HaHaSDP-UCSC/hahardware/specs/patch_antenna-calculations.xlsx

Manufacturer | Bay Area Circuits
Dielectric Material | FR-4
Dielectric Constant | 4.58 | +/-0.02
Dielectric Constant (Effective) | 4.272837247
Trace Height (mils) | 1.9 | +/-0.2
Dielectric Height (mils) | 57
Frequency (GHz) | 2.45
Effective Wavelength (mm) | 59.23753727
Effective Wavelength (mils) | 2332.187766 | 1166.093883 | 583.0469415
Reference | Micro_strip_Patch_Antenna for_2.4_GHZ_Wireless_Applications.pdf |  |  |  |  |  |  |  |  | Note: Width and length are swapped from reference paper.
 | Ground (mm) | Ground (mils) | Substrate (mm) | Substrate (mils) | Patch (mm) | Patch (mils) | Feed (mm) | Feed (mils)
Width | 42 | 1653.5442 | 42 | 1653.5442 | 33 | 1299.2133 | 13 | 511.8113 | 0.5570792022 | of effective wavelength
Length | 47 | 1850.3947 | 47 | 1850.3947 | 38 | 1496.0638 | 3 | 118.1103 | 0.6414851419 | of effective wavelength
Height | 0.2 | 7.87402 | 1.5 | 59.05515 | 0.02 | 0.787402 | 0.02 | 0.787402
 | Notes: | Effecitve dielectric constant of reference design is 3.86.
Actual Design r0.1
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
