HaHaSDP-UCSC/hahardware/specs/base-power_budget.xlsx

Sheet: Kinetis-AT86RF (Inactive)
Typical Power
 |  | V_CC (V) | I_CC (mA) | Power (mW) | %_On | Energy (mWh) | Notes
Kinetis MKW31Z uC |  | 3.3 | 7.2 | 23.76 | 1 | 23.76 | Using run mode current, all clocks enabled.
Kinetis MKW31Z 2.4GHz Antenna RX |  | 3.3 | 6.76 | 22.308 | 0.2 | 4.4616 | Follows "keep-alive" signal.
Kinetis MKW31Z 2.4GHz Antenna TX |  | 3.3 | 6.08 | 20.064 | 0.2 | 4.0128 | Using +0dBm. Send 2 second "keep-alive" signal every 10 seconds.
Kinetis MKW31Z 2.4GHz Antenna Standby |  | 3.3 | 0.2 | 0.66 | 0.6 | 0.396
Atmel AT86RF212B 900MHz Antenna RX |  | 3 | 9.2 | 27.6 | 0.9 | 24.84 | RX if not TX to keep mesh network alive.
Atmel AT86RF212B 900MHz Antenna TX |  | 3 | 23 | 69 | 0.1 | 6.9 | Using +5dBm normal mode. 1 second transmit every 10 seconds.
Atmel AT86RF212B 900MHz Antenna Standby |  | 3 | 0.45 | 1.35 | 0 | 0
TI LM8330 Keypad |  | 1.8 | 0.03 | 0.054 | 0.05 | 0.0027
Crystalfontz CFAH1604A-YYH-JT LCD Controller |  | 3.3 | 1.2 | 3.96 | 0.05 | 0.198
Crystalfontz CFAH1604A-YYH-JT LCD Backlight |  | 4.2 | 220 | 924 | 0.05 | 46.2
LED Lights |  | 12 | 160 | 1920 | 0.01 | 19.2
Audio Speaker |  |  | 125 | 700 | 0.01 | 7
 | Max |  | 559.12
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
