HaHaSDP-UCSC/hahardware/specs/ifa-calculations.xlsx

Manufacturer | Bay Area Circuits
Dielectric Material | FR-4
Dielectric Constant | 4.58 | +/-0.02
Dielectric Constant (Effective) | 4.171349466
Trace Height (mils) | 1.9 | +/-0.2
Dielectric Height (mils) | 57
Frequency (GHz) | 2.45
Effective Wavelength (mm) | 59.95382316
Effective Wavelength (mils) | 2360.388013 | 1180.194007 | 590.0970033
Reference | TI-swru120b.pdf (DN007) |  |  |  |  |  |  | Note: Dielectric information and ground/sides dimensions not given.
 |  | (mm) | (mils) |  | (mm) | (mils)
 | H1 | 5.7 | 224.40957 | W2 | 0.46 | 18.110246
 | H2 | 0.74 | 29.133874 | L1 | 25.58 | 1007.087158 | 0.4266616982 | of effective wavelength
 | H3 | 1.29 | 50.787429 | L2 | 16.4 | 645.66964
 | H4 | 2.21 | 87.007921 | L3 | 2.18 | 85.826818
 | H5 | 0.66 | 25.984266 | L4 | 4.8 | 188.97648
 | H6 | 1.21 | 47.637821 | L5 | 1 | 39.3701
 | H7 | 0.8 | 31.49608 | L6 | 1 | 39.3701
 | H8 | 1.8 | 70.86618 | L7 | 3.2 | 125.98432
 | H9 | 0.61 | 24.015761 | L8 | 0.45 | 17.716545
 | W1 | 1.21 | 47.637821
Actual Design
 |  | (mm) | (mils) |  | (mm) | (mils)
 | H1 | 5.689596928 | 224 | W2 | 0.4571997531 | 18
 | H2 | 0.7365996022 | 29 | L1 | 25.57778619 | 1007 | 0.4266247729 | of effective wavelength
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
