HaHaSDP-UCSC/hahardware/specs/ifa_simple-calculations.xlsx

Manufacturer | Bay Area Circuits
Dielectric Material | FR-4
Dielectric Constant | 4.58 | +/-0.02
Dielectric Constant (Effective) | 4.150918565
Trace Height (mils) | 1.9 | +/-0.2
Dielectric Height (mils) | 57
Frequency (GHz) | 2.45
Effective Wavelength (mm) | 60.10118898
Effective Wavelength (mils) | 2366.18982 | 1183.09491 | 591.5474551
Reference | NXP-AN2731.pdf (9.1 - Inverted-F Antenna) |  |  |  |  | Note: Dielectric information and ground/sides dimensions not given.
 |  | (mm) | (mils)
 | H1 | 10 | 393.701
 | H2 | 7.8 | 307.08678
 | W1 | 2.5 | 98.42525
 | W2 | 0.85 | 33.464585
 | W3 | 3 | 118.1103
 | L1 | 23.8 | 937.00838 | 0.3959988214 | of effective wavelength
 | L2 | 4.05 | 159.448905
Actual Design
 |  | (mm) | (mils)
 | H1 | 10.0075946 | 394
 | H2 | 7.797795789 | 307
 | W1 | 2.489198656 | 98
 | W2 | 0.8381995474 | 33
 | W3 | 2.997198382 | 118
 | L1 | 23.79978715 | 937 | 0.3959952798 | of effective wavelength
 | L2 | 4.038597819 | 159
 | Sides | 7.619995885 | 300
 | Notes: | CPWG feedline impedance of 49.95ohm generated with 91mil trace width and 10mil ground spacing on each side.
 |  | One row of vias placed 20mils from the keepout, 118mils apart from each other, and 61mils away from the CPWG.
