HaHaSDP-UCSC/hahardware/pcb/kicad/antenna/2.4ghz/chip/Chip Antenna/Kicad lib message.PNG

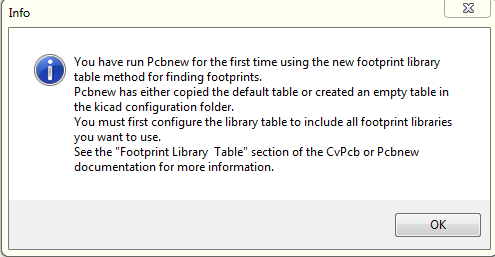
pcb/kicad/antenna/2.4ghz/chip/Chip Antenna/Kicad lib message.PNG
