HaHaSDP-UCSC/hahardware/specs/conversions.ods

L1 | 3.94 | 155.118194
L2 | 2.7 | 106.29927
L3 | 5 | 196.8505
L4 | 2.64 | 103.937064
L5 | 2 | 78.7402
L6 | 4.9 | 192.91349
W1 | 0.9 | 35.43309
W2 | 0.5 | 19.68505
D1 | 0.5 | 19.68505
D2 | 0.3 | 11.81103
D3 | 0.3 | 11.81103
D4 | 0.5 | 19.68505
D5 | 1.4 | 55.11814
D6 | 1.7 | 66.92917
WG width |  | 90.2
Gap width |  | 10
Wavelength/6 |  | 820.2083333333
Focal distance |  | 40
Via diameter |  | 12
Via drill/hole diameter |  | 10
 | 24.6 | 968.50446
 | 5.5 | 216.53555
 | 21.2 | 834.64612
 | 4 | 157.4804
