HaHaSDP-UCSC/hahardware/specs/base-bom.xlsx

Component | Part Name | Manufacturer | Package | Value | # | Supplier | Cost per 1 | Total for 1 | Cost per 50 | Total for 50 | Cost per 100 | Total for 100
B1 | KS-01Q-01 | E-Switch |  |  | 1 | Mouser | $0.52 | $0.52 | $0.45 | $22.35 | $0.43 | $43.50
B2 | KS-01Q-01 | E-Switch |  |  | 1 | Mouser | $0.52 | $0.52 | $0.45 | $22.35 | $0.43 | $43.50
B3 | KS-01Q-01 | E-Switch |  |  | 1 | Mouser | $0.52 | $0.52 | $0.45 | $22.35 | $0.43 | $43.50
B4 | KS-01Q-01 | E-Switch |  |  | 1 | Mouser | $0.52 | $0.52 | $0.45 | $22.35 | $0.43 | $43.50
B5 | KS-01Q-01 | E-Switch |  |  | 1 | Mouser | $0.52 | $0.52 | $0.45 | $22.35 | $0.43 | $43.50
C8 | GRM1555C1H100FA01D | Murata | SMT0402 | 10pF | 1 | Mouser | $0.10 | $0.10 | $0.023 | $1.15 | $0.016 | $1.60
C9 | GRM1555C1H100FA01D | Murata | SMT0403 | 10pF | 1 | Mouser | $0.10 | $0.10 | $0.023 | $1.15 | $0.016 | $1.60
C10 | GRM155R61A105KE01D | Murata | SMT0402 | 1.0uF | 1 | Mouser | $0.10 | $0.10 | $0.013 | $0.65 | $0.009 | $0.90
C11 | GRM155R61H104JE14D | Murata | SMT0402 | 0.1uF | 1 | Mouser | $0.10 | $0.10 | $0.014 | $0.70 | $0.009 | $0.90
C12 | GRM155R61H104JE14D | Murata | SMT0402 | 0.1uF | 1 | Mouser | $0.10 | $0.10 | $0.014 | $0.70 | $0.009 | $0.90
C13 | GRM155R61H104JE14D | Murata | SMT0402 | 0.1uF | 1 | Mouser | $0.10 | $0.10 | $0.014 | $0.70 | $0.009 | $0.90
C14 | 04026D475KAT2A | AVX | SMT0402 | 4.7uF | 1 | Mouser | $0.13 | $0.13 | $0.115 | $5.75 | $0.10 | $10.40
C15 | GRM155R61H104JE14D | Murata | SMT0402 | 0.1uF | 1 | Mouser | $0.10 | $0.10 | $0.014 | $0.70 | $0.0090 | $0.90
C16 | GRM155R61A225KE95D | Murata | SMT0402 | 2.2uF | 1 | Mouser | $0.10 | $0.10 | $0.060 | $3.00 | $0.027 | $2.70
C17 | GRM155R71H103JA88D | Murata | SMT0402 | 0.01uF | 1 | Mouser | $0.10 | $0.10 | $0.009 | $0.45 | $0.006 | $0.60
C18 | GRM155R61A105KE01D | Murata | SMT0402 | 1.0uF | 1 | Mouser | $0.10 | $0.10 | $0.013 | $0.65 | $0.009 | $0.90
C19 | GRM155R61A105KE01D | Murata | SMT0402 | 1.0uF | 1 | Mouser | $0.10 | $0.10 | $0.013 | $0.65 | $0.009 | $0.90
C20 | GRM155R61A105KE01D | Murata | SMT0402 | 1.0uF | 1 | Mouser | $0.10 | $0.10 | $0.013 | $0.65 | $0.009 | $0.90
C21 | GRM1555C1H470FA01D | Murata | SMT0402 | 47pF | 1 | Mouser | $0.10 | $0.10 | $0.023 | $1.15 | $0.016 | $1.60
C22 | GRM155R61A105KE01D | Murata | SMT0402 | 1.0uF | 1 | Mouser | $0.10 | $0.10 | $0.013 | $0.65 | $0.009 | $0.90
C23 | GRM155C80J106ME11D | Murata | SMT0402 | 10uF | 1 | Mouser | $0.16 | $0.16 | $0.062 | $3.10 | $0.043 | $4.30
DS1-1 | CFAH1604A-TMI-JT | Crystalfontz |  | 16x4 | 1 | Crystalfontz | $9.48 | $9.48 | $7.65 | $382.50 | $7.53 | $753.00
DS1-2 | PREC016SAAN-RC | Sullins |  |  | 1 | Digikey | $0.30 | $0.30 | $0.272 | $13.60 | $0.2239 | $22.39
DS1-3 | 310-87-116-41-001101 | Preci-Dip |  |  | 1 | Digikey | $0.91 | $0.91 | $0.796 | $39.80 | $0.6866 | $68.66
FB1 | BLM18PG181SN1D | Murata | SMT0603 |  | 1 | Mouser | $0.10 | $0.10 | $0.05 | $2.50 | $0.04 | $4.33
H1 | 302-R201 | On Shore |  |  | 1 | Digikey | $0.62 | $0.62 | $0.4632 | $23.16 | $0.4439 | $44.39
H2 | 10118194-0001LF | Amphenol |  |  | 1 | Mouser | $0.46 | $0.46 | $0.318 | $15.90 | $0.275 | $27.50
L3 | 36401E9N1ATDF | TE Connectivity | SMT0402 | 9.1nH | 1 | Mouser | $0.10 | $0.10 | $0.071 | $3.55 | $0.061 | $6.10
L4 | CV201210-4R7K | Bourns | SMT0805 | 4.7uH | 1 | Mouser | $0.10 | $0.10 | $0.048 | $2.40 | $0.039 | $3.90
P1 | OSTTE020104 | On Shore |  |  | 1 | Arrow | $0.3467 | $0.35 | $0.2442 | $12.21 | $0.2442 | $24.42
P2 | OSTTE020105 | On Shore |  |  | 1 | Arrow | $0.3467 | $0.35 | $0.2442 | $12.21 | $0.2442 | $24.42
P3 | OSTTE020106 | On Shore |  |  | 1 | Arrow | $0.3467 | $0.35 | $0.2442 | $12.21 | $0.2442 | $24.42
P4 | OSTTE020106 | On Shore |  |  | 1 | Arrow | $0.3467 | $0.35 | $0.2442 | $12.21 | $0.2442 | $24.42
Q1 | IRLML2502TRPBF | Infineon | SOT-23 |  | 1 | Mouser | $0.46 | $0.46 | $0.33 | $16.45 | $0.15 | $15.10
R2 | RCS04021K00FKED | Vishay | SMT0402 | 1kOhm | 1 | Mouser | $0.11 | $0.11 | $0.11 | $5.50 | $0.038 | $3.80
R3 | RCS0402100KFKED | Vishay | SMT0402 | 100kOhm | 1 | Mouser | $0.11 | $0.11 | $0.11 | $5.50 | $0.038 | $3.80
R4 | RCS0402100RFKED | Vishay | SMT0402 | 100 Ohm | 1 | Mouser | $0.11 | $0.11 | $0.11 | $5.50 | $0.038 | $3.80
R5 | RCS04021K00FKED | Vishay | SMT0402 | 1kOhm | 1 | Mouser | $0.11 | $0.11 | $0.11 | $5.50 | $0.038 | $3.80
RV1 | 3319W-1-103 | Bourns |  | 10kOhm | 1 | Mouser | $0.40 | $0.40 | $0.319 | $15.95 | $0.286 | $28.60
U1 | ATSAMB11G18A-MU-T | Microchip (Atmel) | QFN48 |  | 1 | Microchip | $3.51 | $3.51 | $3.21 | $160.50 | $3.02 | $302.00
U2 | XBP9B-DMST-002 | Digi |  |  | 1 | Digikey | $39.00 | $39.00 | $39.00 | $1950.00 | $39.00 | $3900.00
Y1 | ABS07AIG-32.768KHZ-6-T | Abracon | 2-SMD | 32.768kHz | 1 | Digikey | $0.71 | $0.71 | $3.21 | $160.50 | $0.52 | $51.62
Y2 | CX3225SB26000D0FFFCC | Kyocera (AVX) | 4-SMD | 26MHz | 1 | Mouser | $0.76 | $0.76 | $0.66 | $33.15 | $0.56 | $56.00
AE2-1 | ANT-916-PML | Linx |  | 916MHz | 1 | Digikey | $8.12 | $8.12 | $7.50 | $375.00 | $6.90 | $690.00
AE2-2 | 132193 | Amphenol |  |  | 1 | Newark | $6.12 | $6.12 | $5.10 | $255.00 | $4.85 | $485.00
 |  |  |  |  |  | Total |  | $77.27 |  | $3654.35 |  | $6819.87
 |  |  |  |  |  | Total per unit |  | $77.27 |  | $73.09 |  | $68.20
