HaHaSDP-UCSC/hahardware/pcb/kicad/antenna/2.4ghz/mifa_TI/SampDesign/IFA_USB.dxf

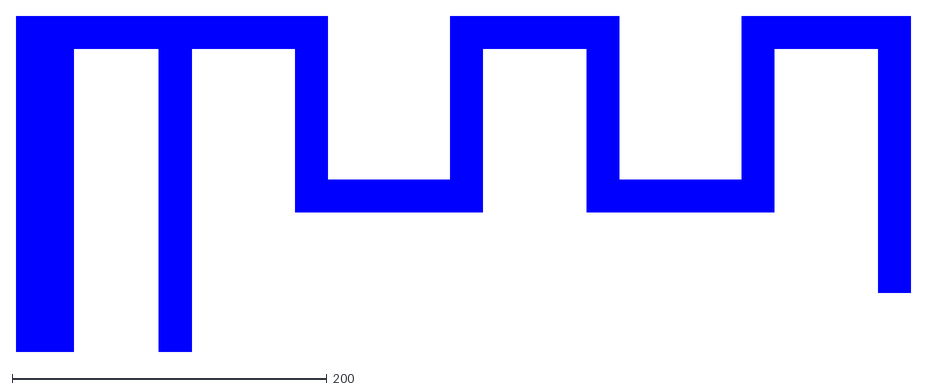
[picture p2: CAD file, 2017-06-19]
pcb/kicad/antenna/2.4ghz/mifa_TI/SampDesign/IFA_USB.dxf
567.9 x 213.2
