HaHaSDP-UCSC/hahardware/pcb/kicad/button/button_mkii/mifasketches/mifa_05-B.Cu.dxf

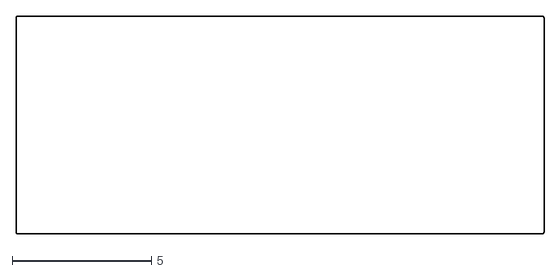
[picture p3: CAD file, 2017-06-19]
pcb/kicad/button/button_mkii/mifasketches/mifa_05-B.Cu.dxf
19.0 x 7.82
