HaHaSDP-UCSC/hahardware/pcb/kicad/button/button_mkii/mifasketches/mifa_05-F.Cu.dxf

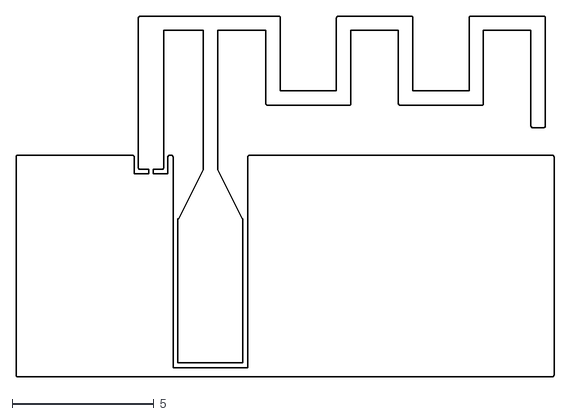
[picture p4: CAD file, 2017-06-19]
pcb/kicad/button/button_mkii/mifasketches/mifa_05-F.Cu.dxf
19.0 x 12.7
