HaHaSDP-UCSC/hahardware/(list of files, cad)

Other CAD files:
pcb/kicad/button/button_mkii/mifasketches/mifa_05-B.Adhes.dxf
pcb/kicad/button/button_mkii/mifasketches/mifa_05-F.Adhes.dxf
pcb/kicad/button/button_mkii/mifasketches/mifa_05-B.Mask.dxf
pcb/kicad/button/button_mkii/mifasketches/mifa_05-B.Paste.dxf
pcb/kicad/button/button_mkii/mifasketches/mifa_05-B.SilkS.dxf
pcb/kicad/button/button_mkii/mifasketches/mifa_05-F.Mask.dxf
pcb/kicad/button/button_mkii/mifasketches/mifa_05-F.Paste.dxf
pcb/kicad/button/button_mkii/mifasketches/mifa_05-F.SilkS.dxf
