HaHaSDP-UCSC/hahardware/pcb/kicad/base/base-schematic.pdf

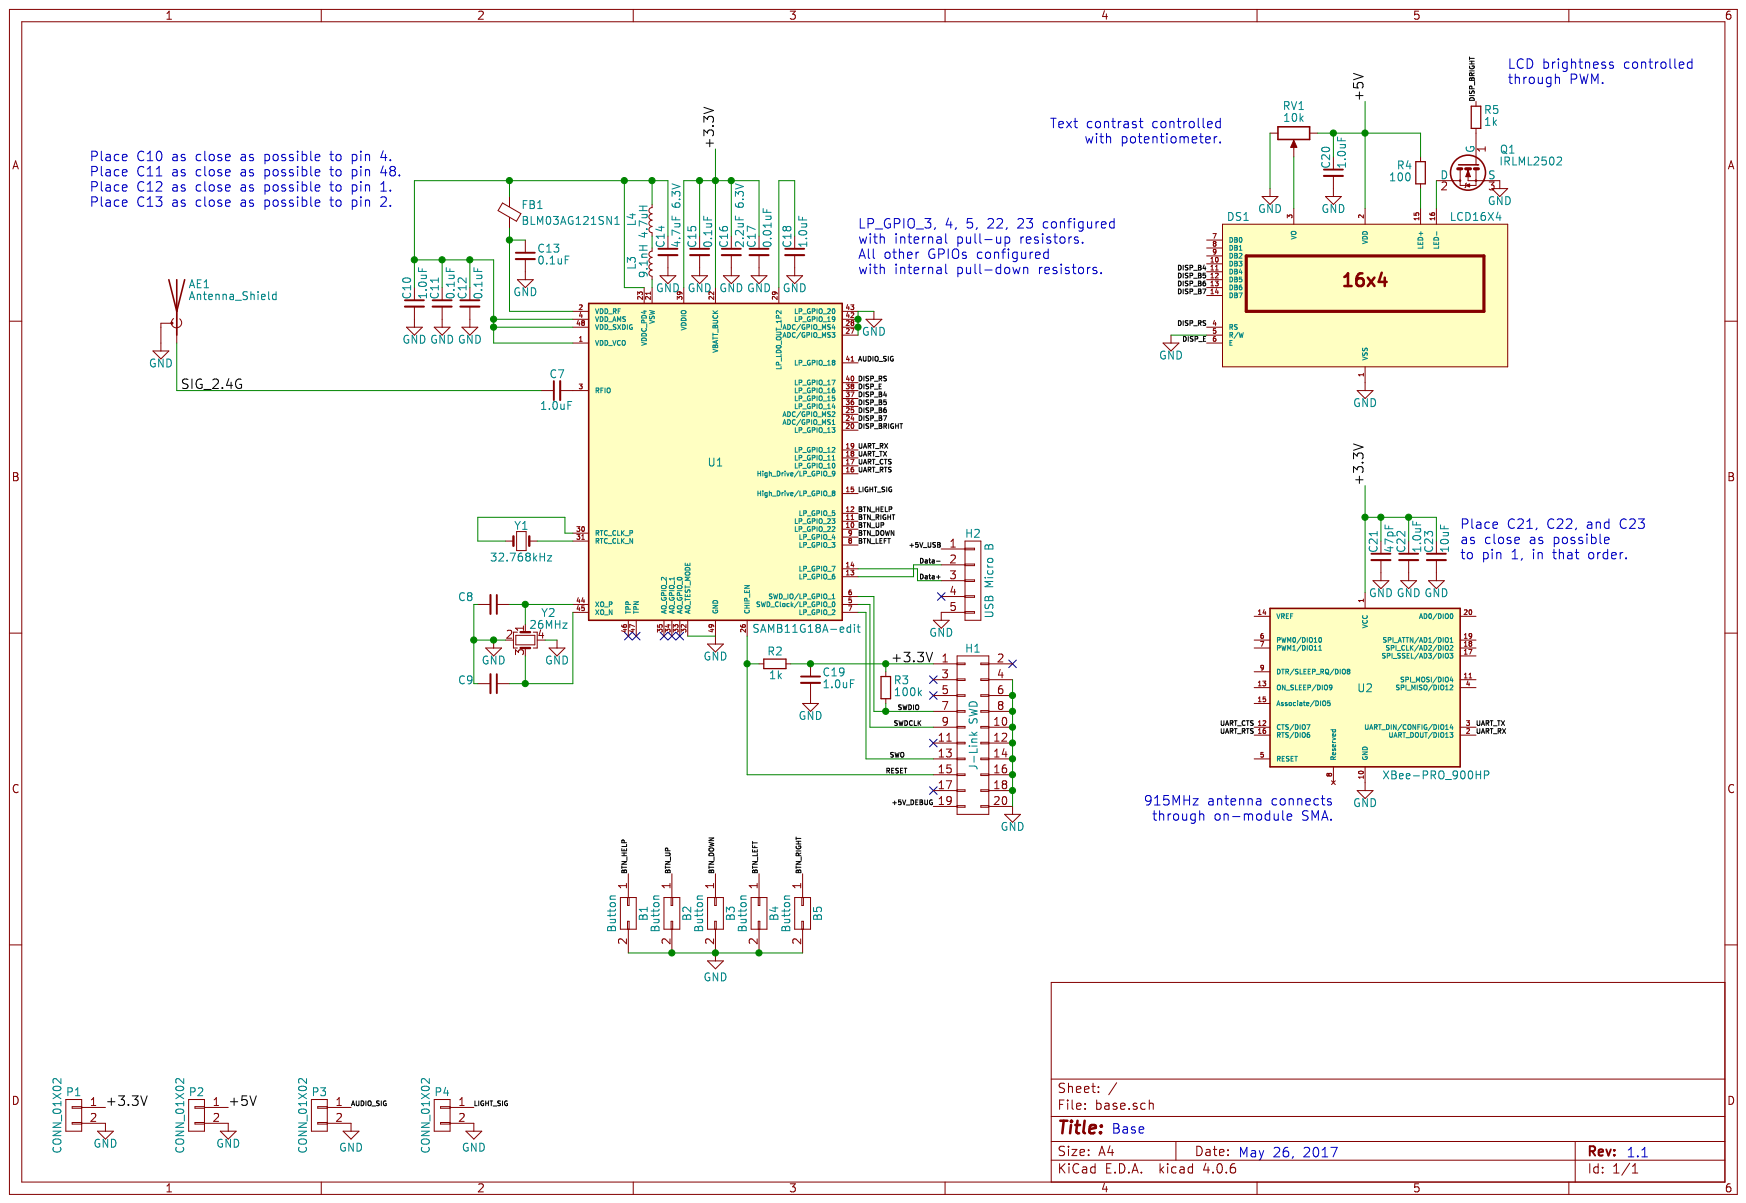
[picture p5: page 1]
