HaHaSDP-UCSC/hahardware/pcb/kicad/artwork/base-bot.pdf

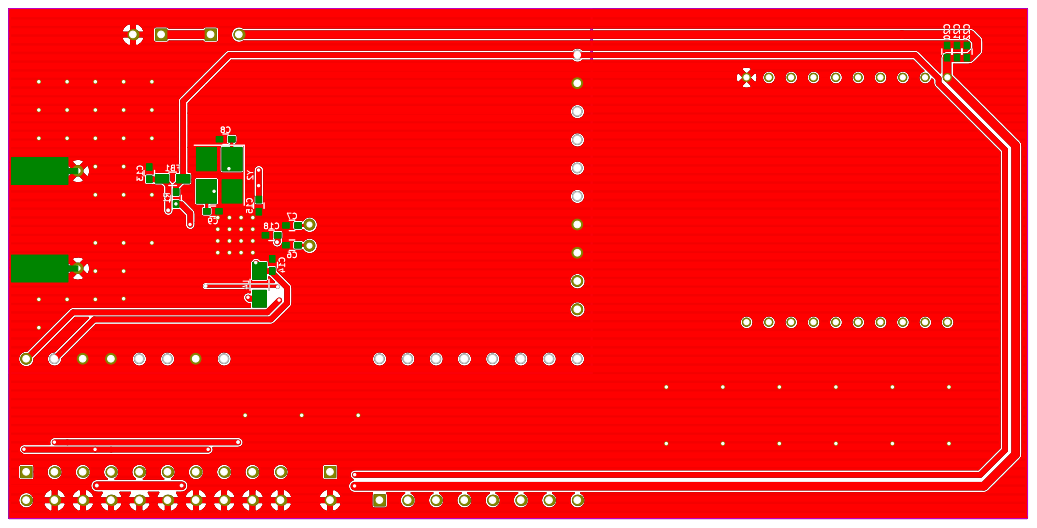
[picture p6: page 1]
