HaHaSDP-UCSC/hahardware/pcb/kicad/artwork/base-top.pdf

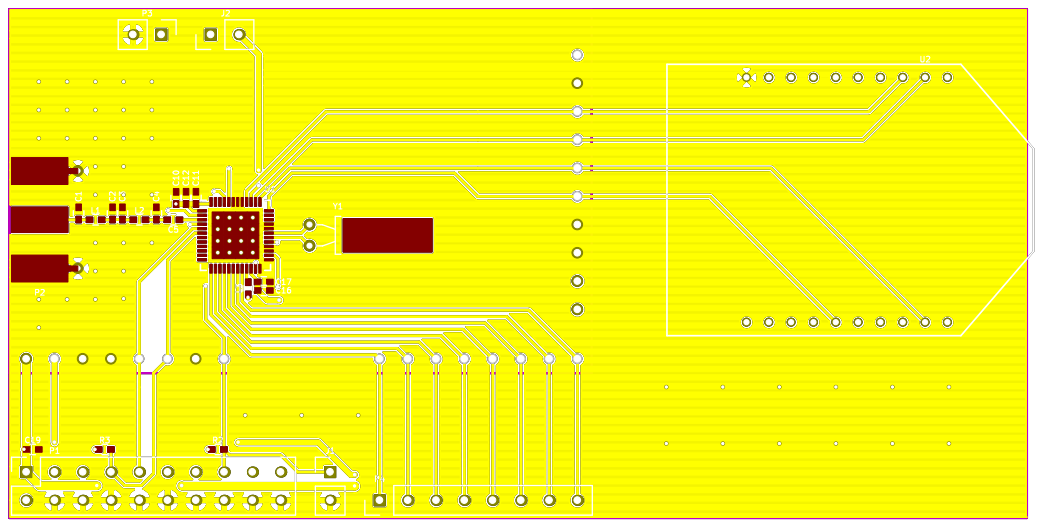
[picture p7: page 1]
