HaHaSDP-UCSC/hahardware/pcb/kicad/base/artwork/base-bot.pdf

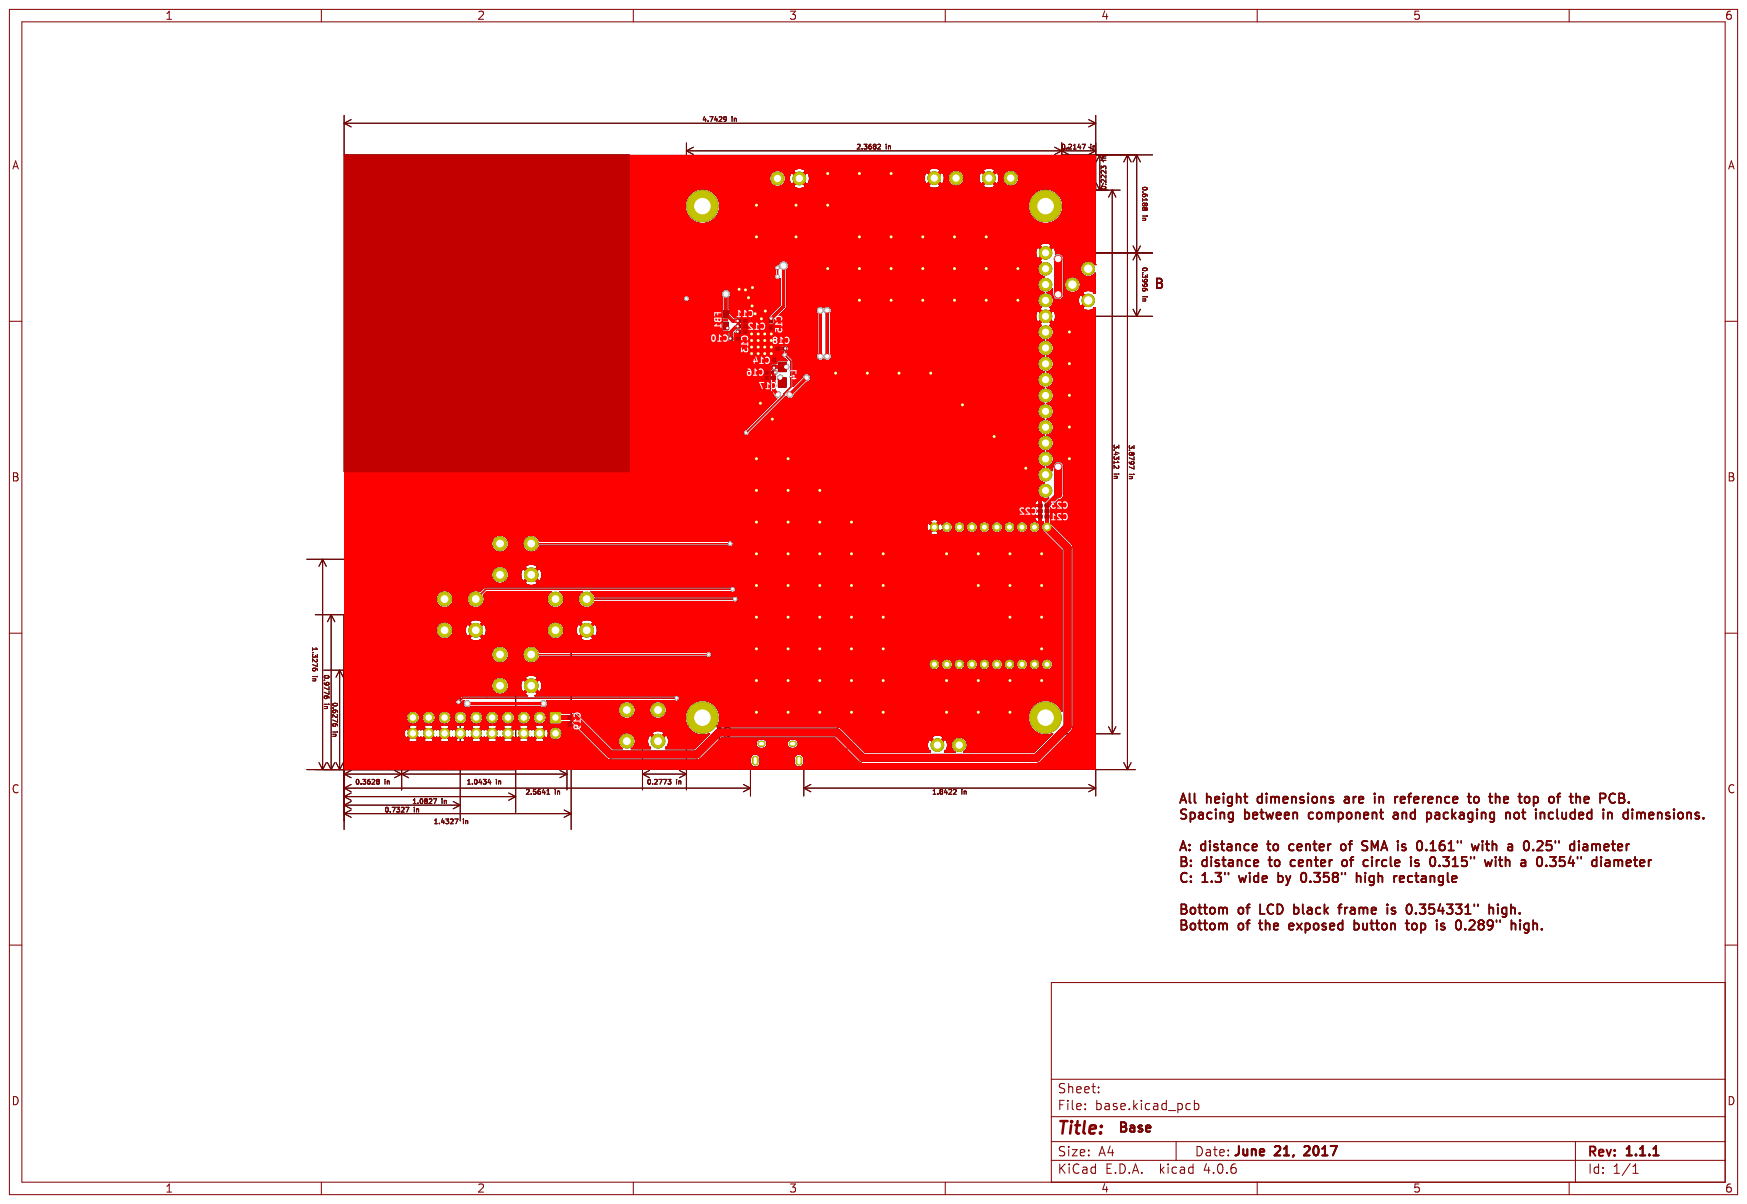
[picture p8: page 1]
