HaHaSDP-UCSC/hahardware/pcb/kicad/base/artwork/base-top.pdf

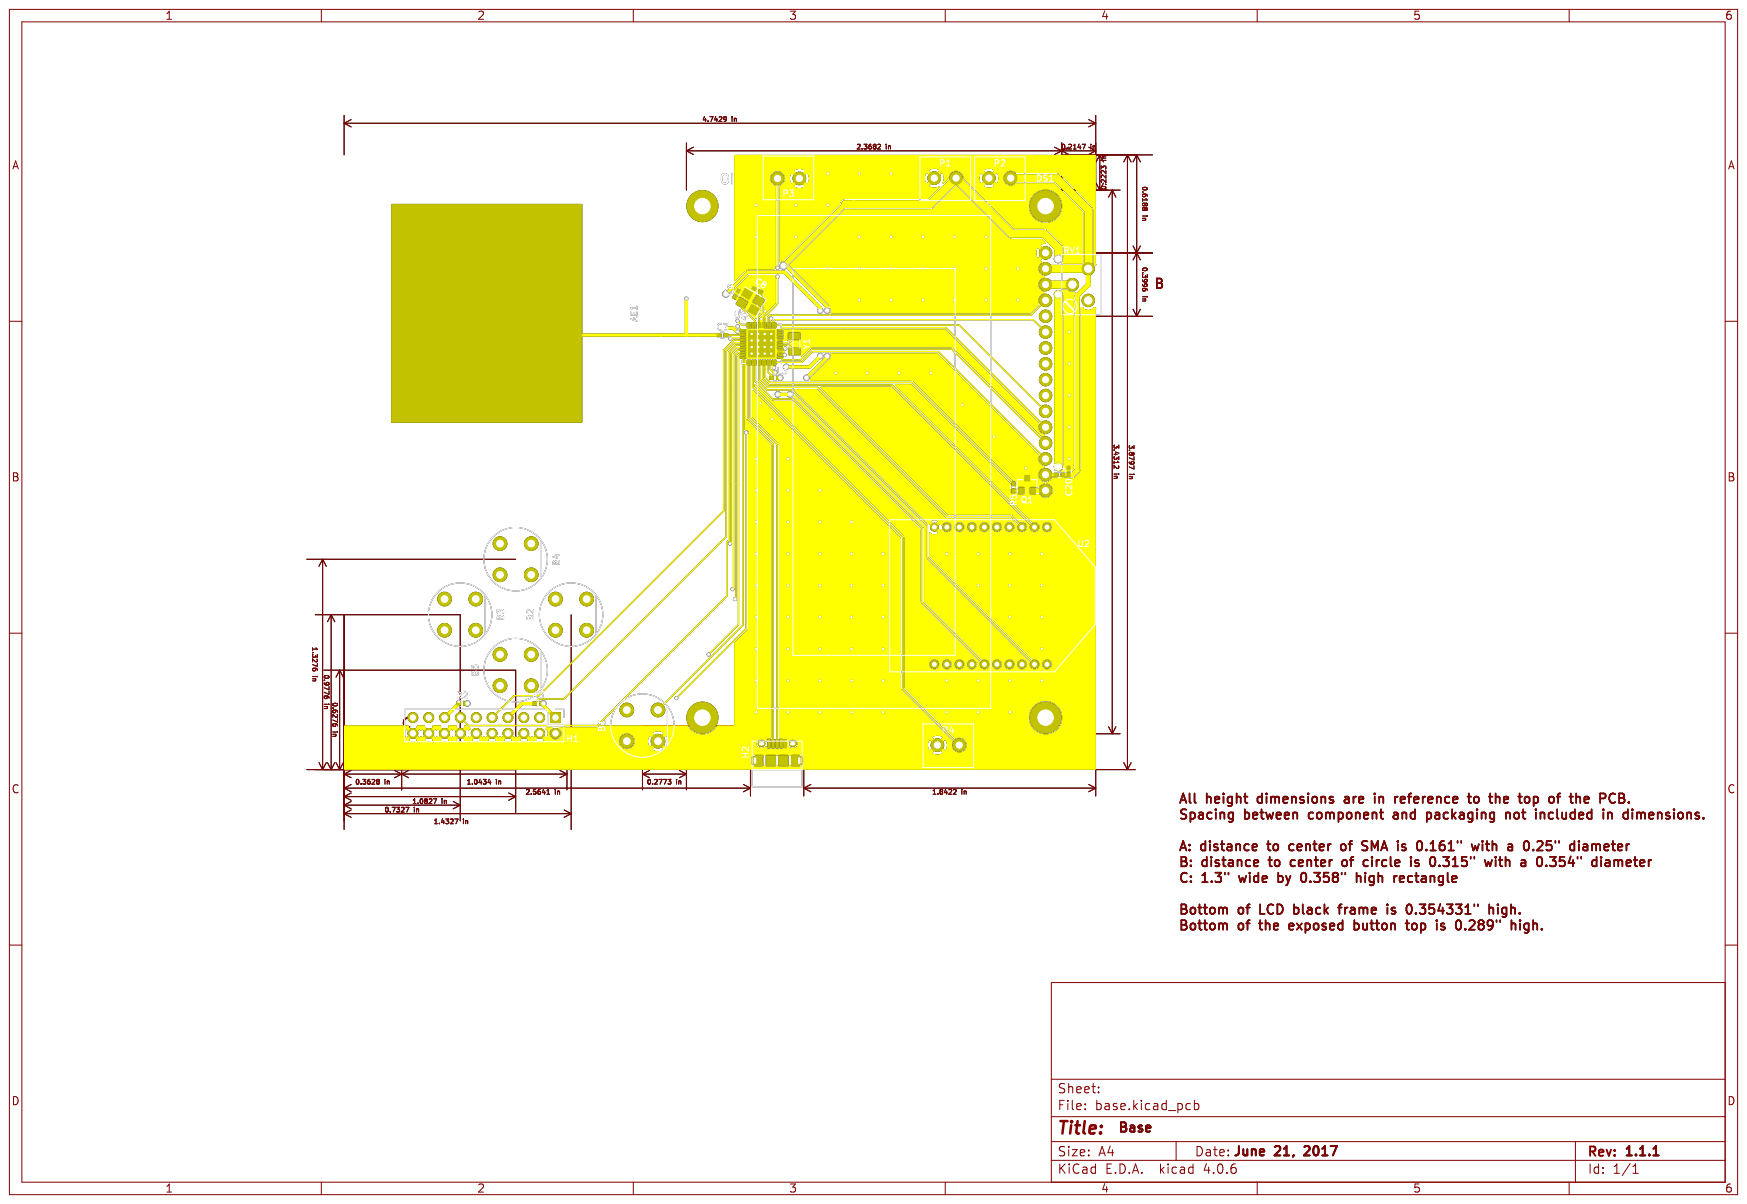
[picture p9: page 1]
