HaHaSDP-UCSC/hahardware/pcb/kicad/button/button_mki/mki.pdf

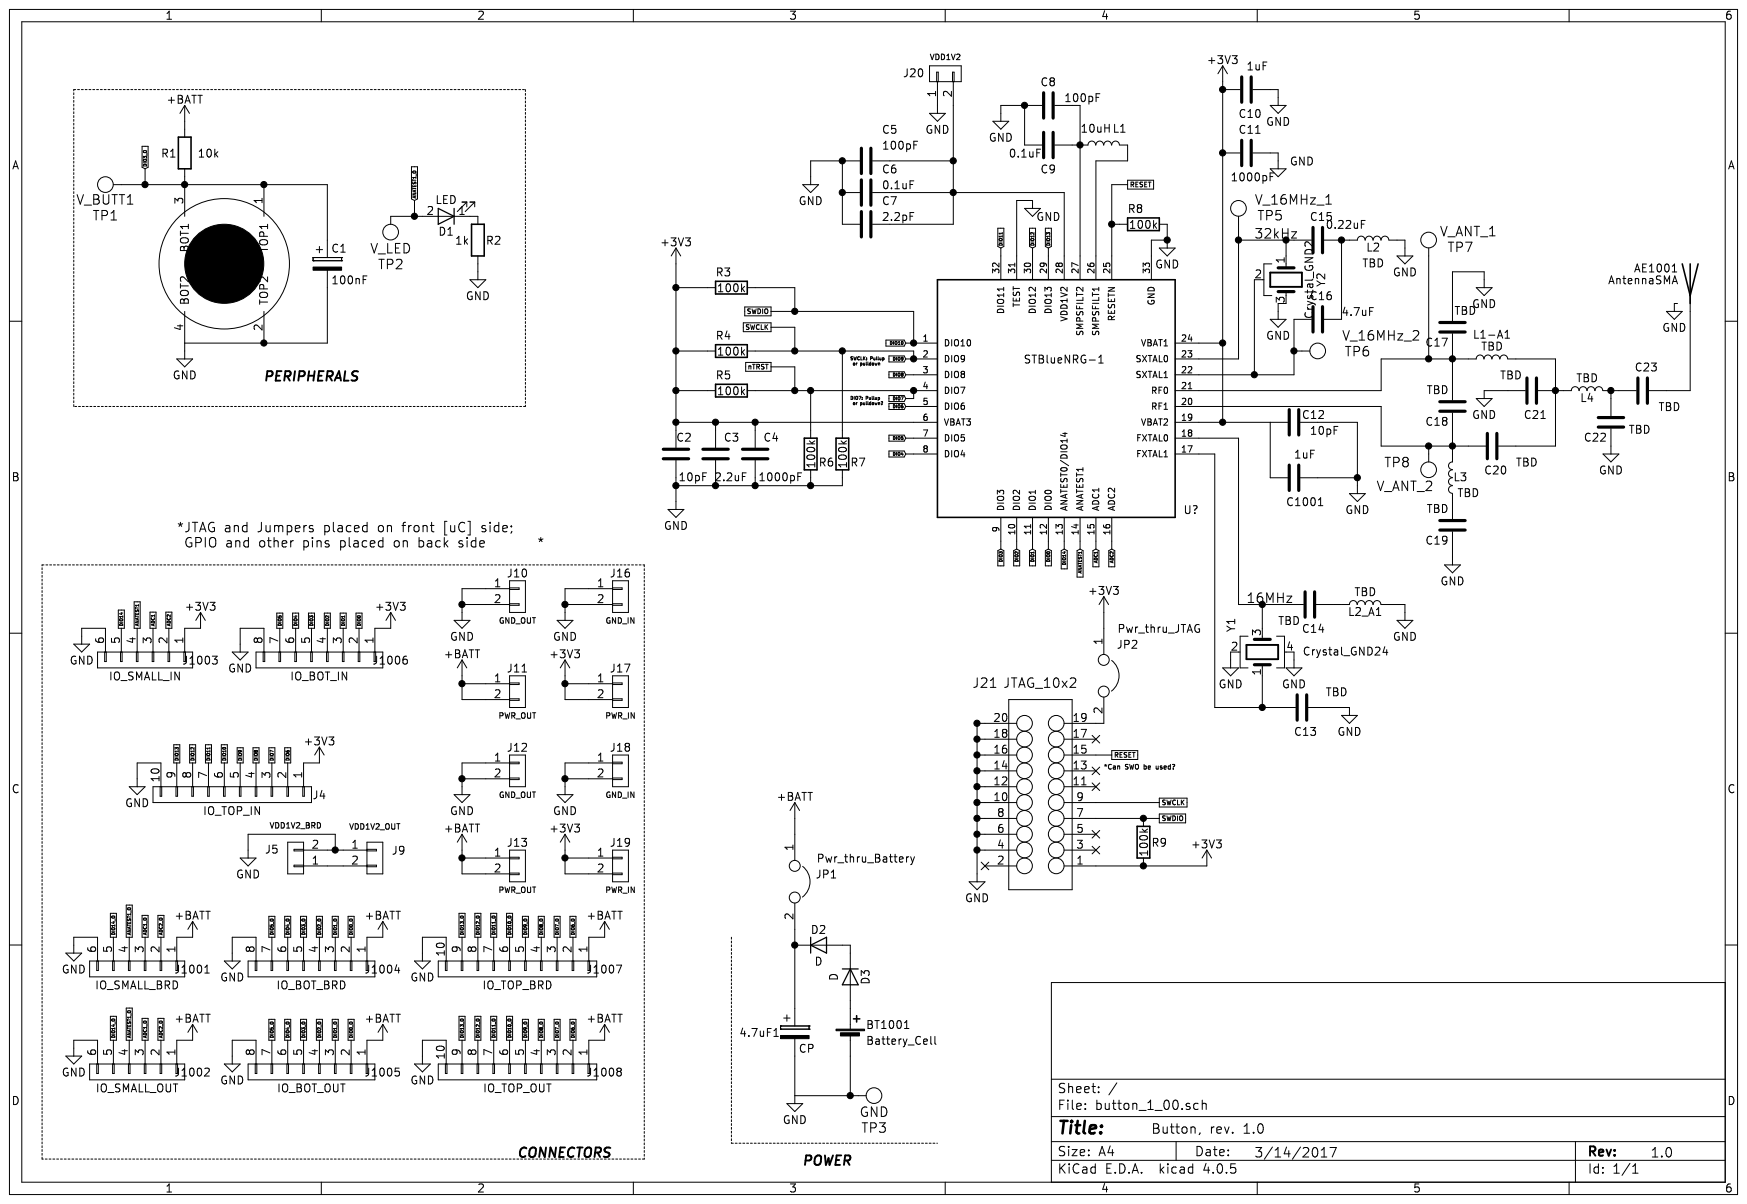
[picture p10: page 1]
