HaHaSDP-UCSC/hahardware/pcb/kicad/antenna/2.4ghz/ifa_simple/ifa_simple.pdf

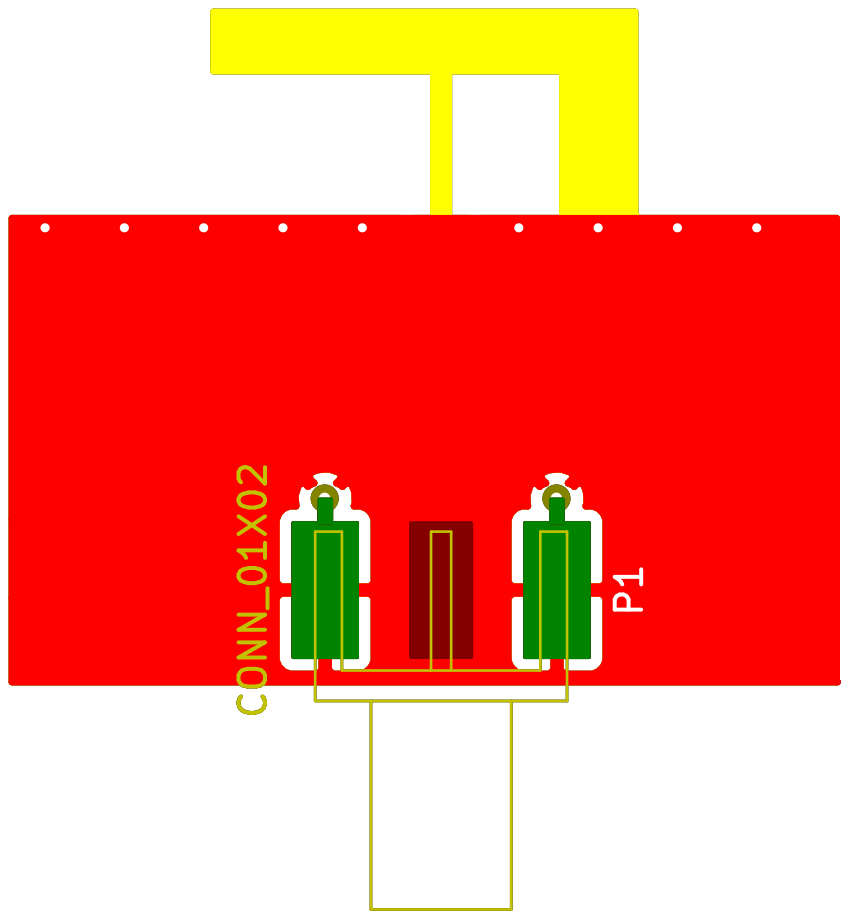
[picture p23: page 1]
