HaHaSDP-UCSC/hahardware/pcb/kicad/antenna/2.4ghz/mifa/mifa.pdf

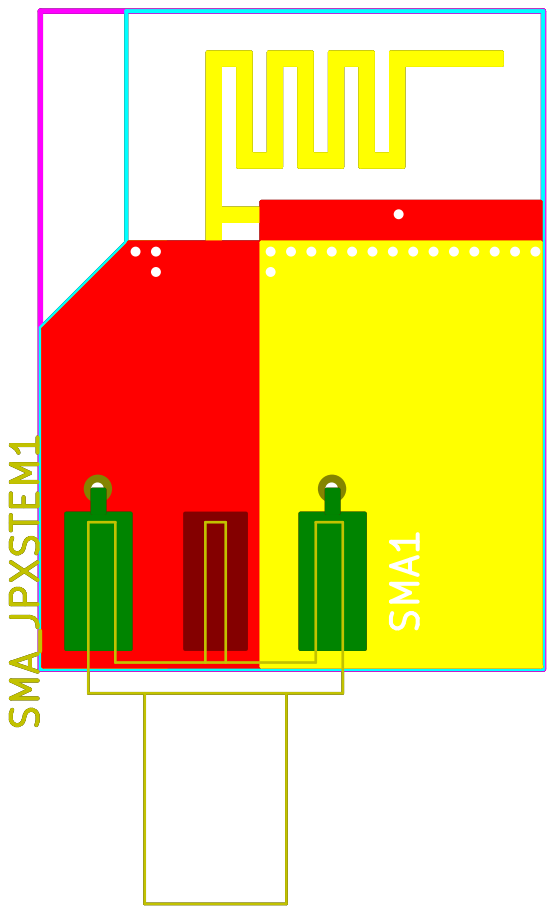
[picture p24: page 1]
