HaHaSDP-UCSC/hahardware/pcb/kicad/antenna/2.4ghz/ifa/ifa.pdf

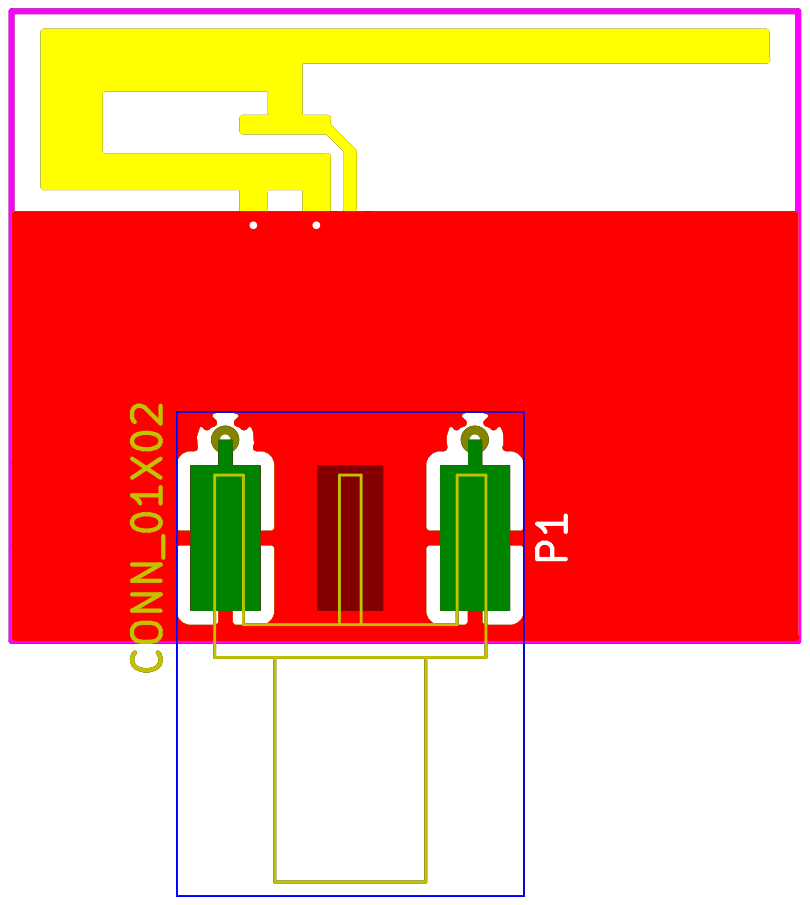
[picture p25: page 1]
