HaHaSDP-UCSC/hahardware/pcb/kicad/antenna/2.4ghz/patch_match/artwork/patch_match-bot.pdf

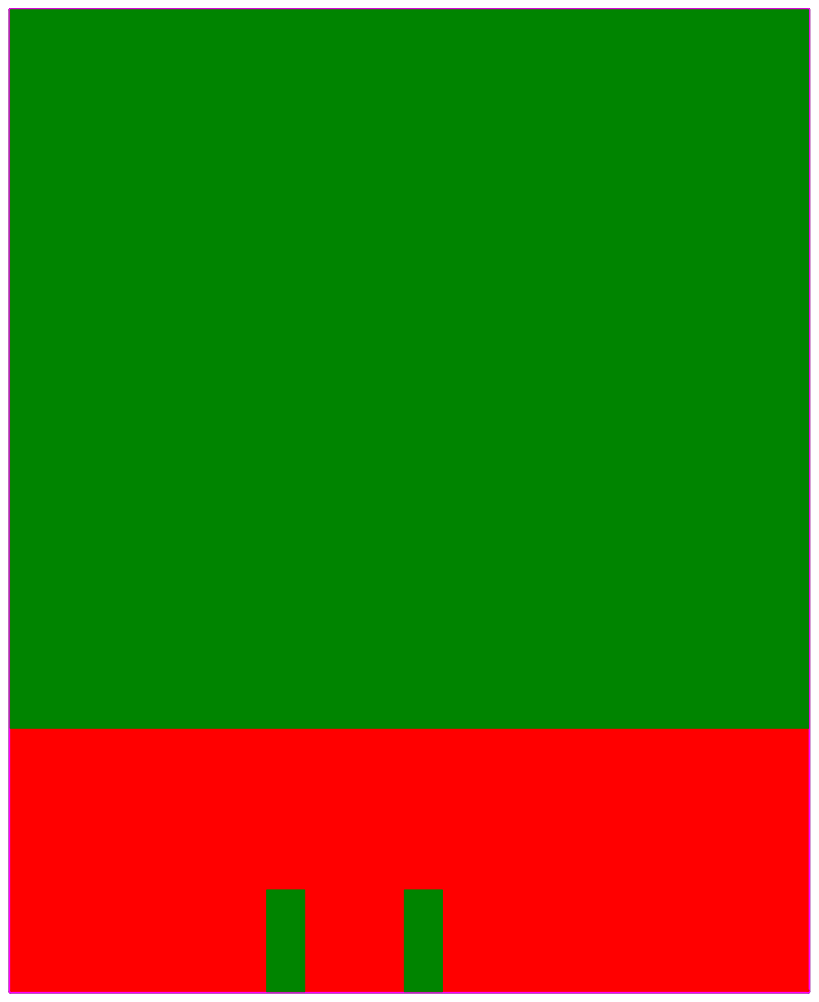
[picture p26: page 1]
