HaHaSDP-UCSC/hahardware/pcb/kicad/antenna/2.4ghz/patch_match/artwork/patch_match-top.pdf

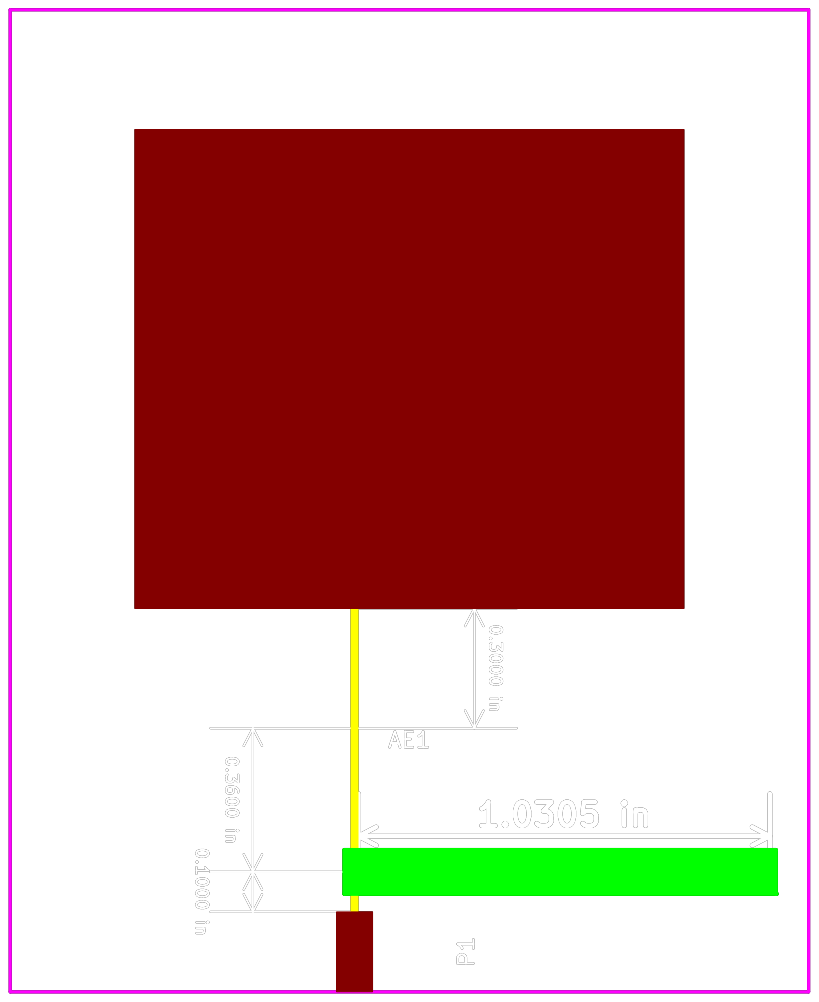
[picture p27: page 1]
