HaHaSDP-UCSC/hahardware/pcb/kicad/antenna/2.4ghz/patch/artwork/patch-bot.pdf

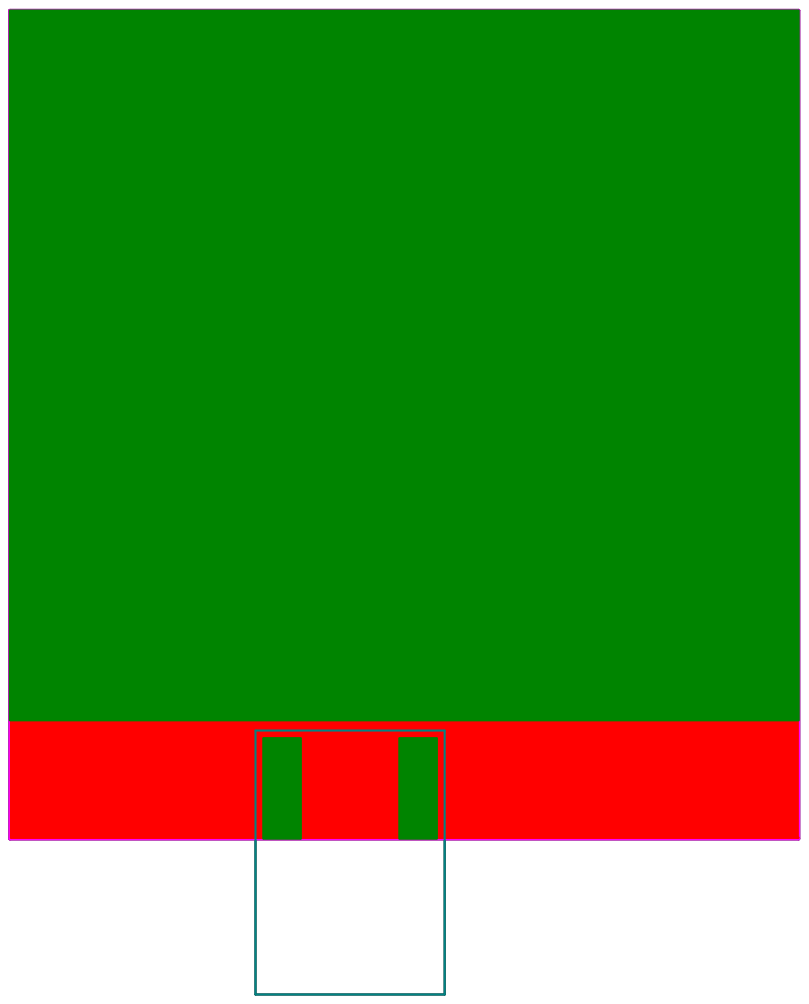
[picture p28: page 1]
