HaHaSDP-UCSC/hahardware/pcb/kicad/antenna/2.4ghz/patch/artwork/patch-top.pdf

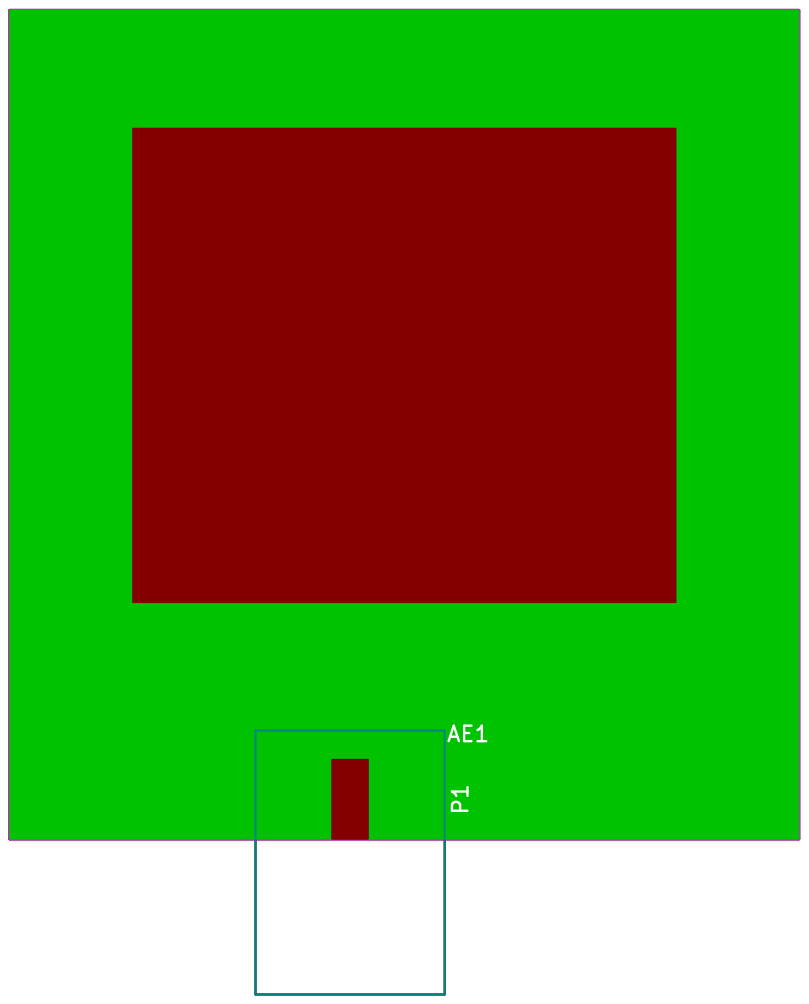
[picture p29: page 1]
