HaHaSDP-UCSC/hahardware/pcb/kicad/antenna/2.4ghz/patch_balun/artwork/patch_balun-bot.pdf

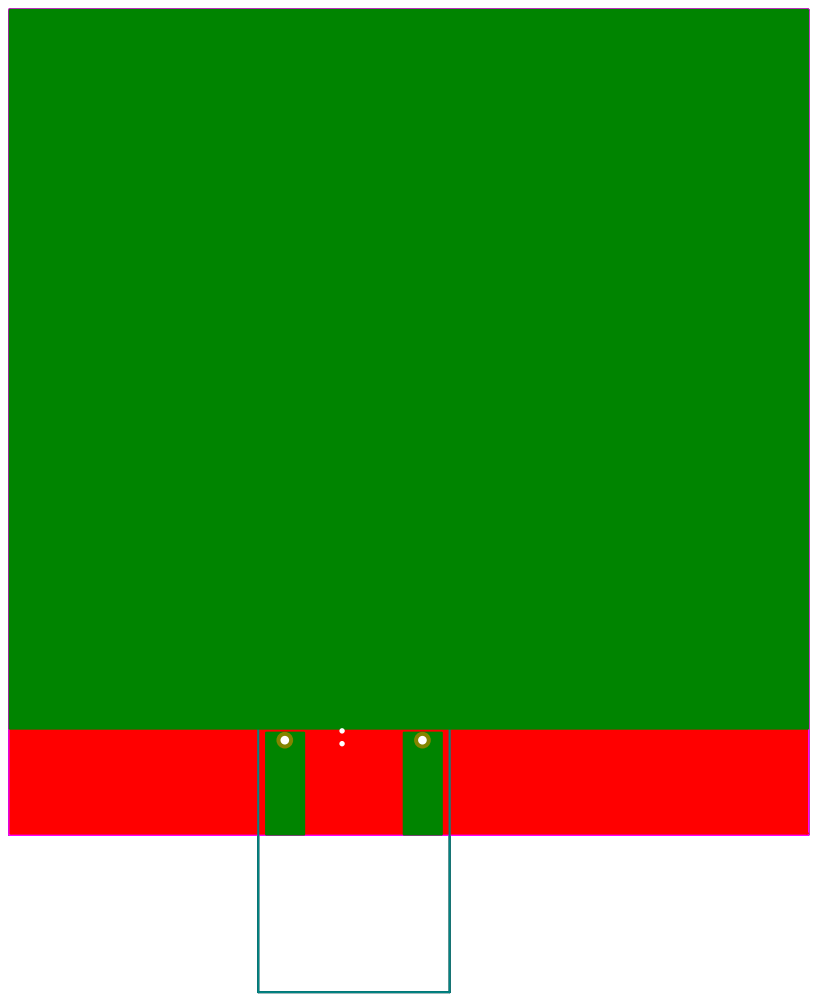
[picture p30: page 1]
