HaHaSDP-UCSC/hahardware/pcb/kicad/antenna/2.4ghz/patch_balun/artwork/patch_balun-top.pdf

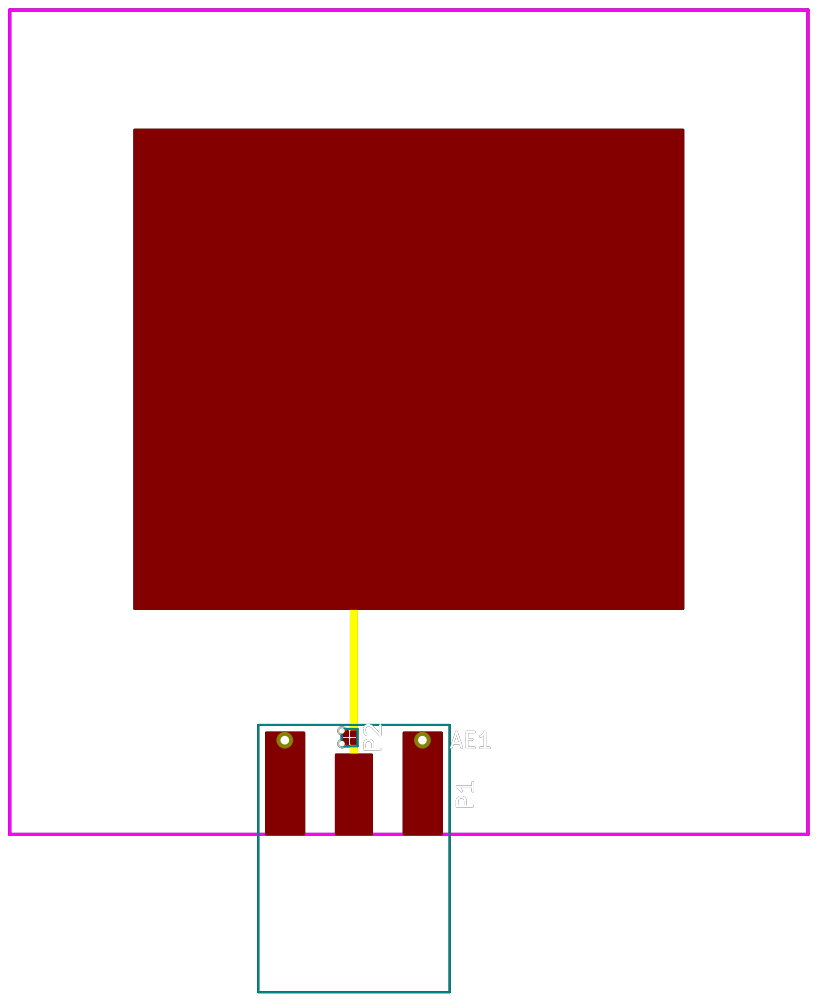
[picture p31: page 1]
