HaHaSDP-UCSC/hahardware/pcb/kicad/antenna/2.4ghz/chip/antenova/rufa.pdf

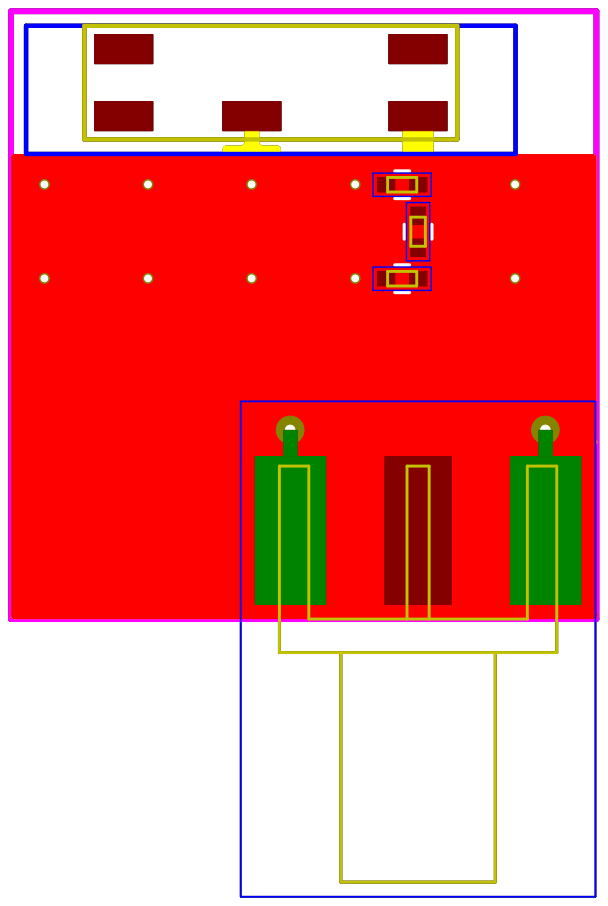
[picture p32: page 1]
