HaHaSDP-UCSC/hahardware/(list of files, drawings)

Other design files:
pcb/kicad/antenna/2.4ghz/mifa_TI/SampDesign/CC2511_USB_Dongle_1_3.pcb
pcb/kicad/button/button_mkii/mifasketches/mifa_05.dsn
