HaHaSDP-UCSC/hahardware/pcb/kicad/base/base.kicad_pcb

## KiCad design pcb/kicad/base/base.kicad_pcb (2017-06-22)

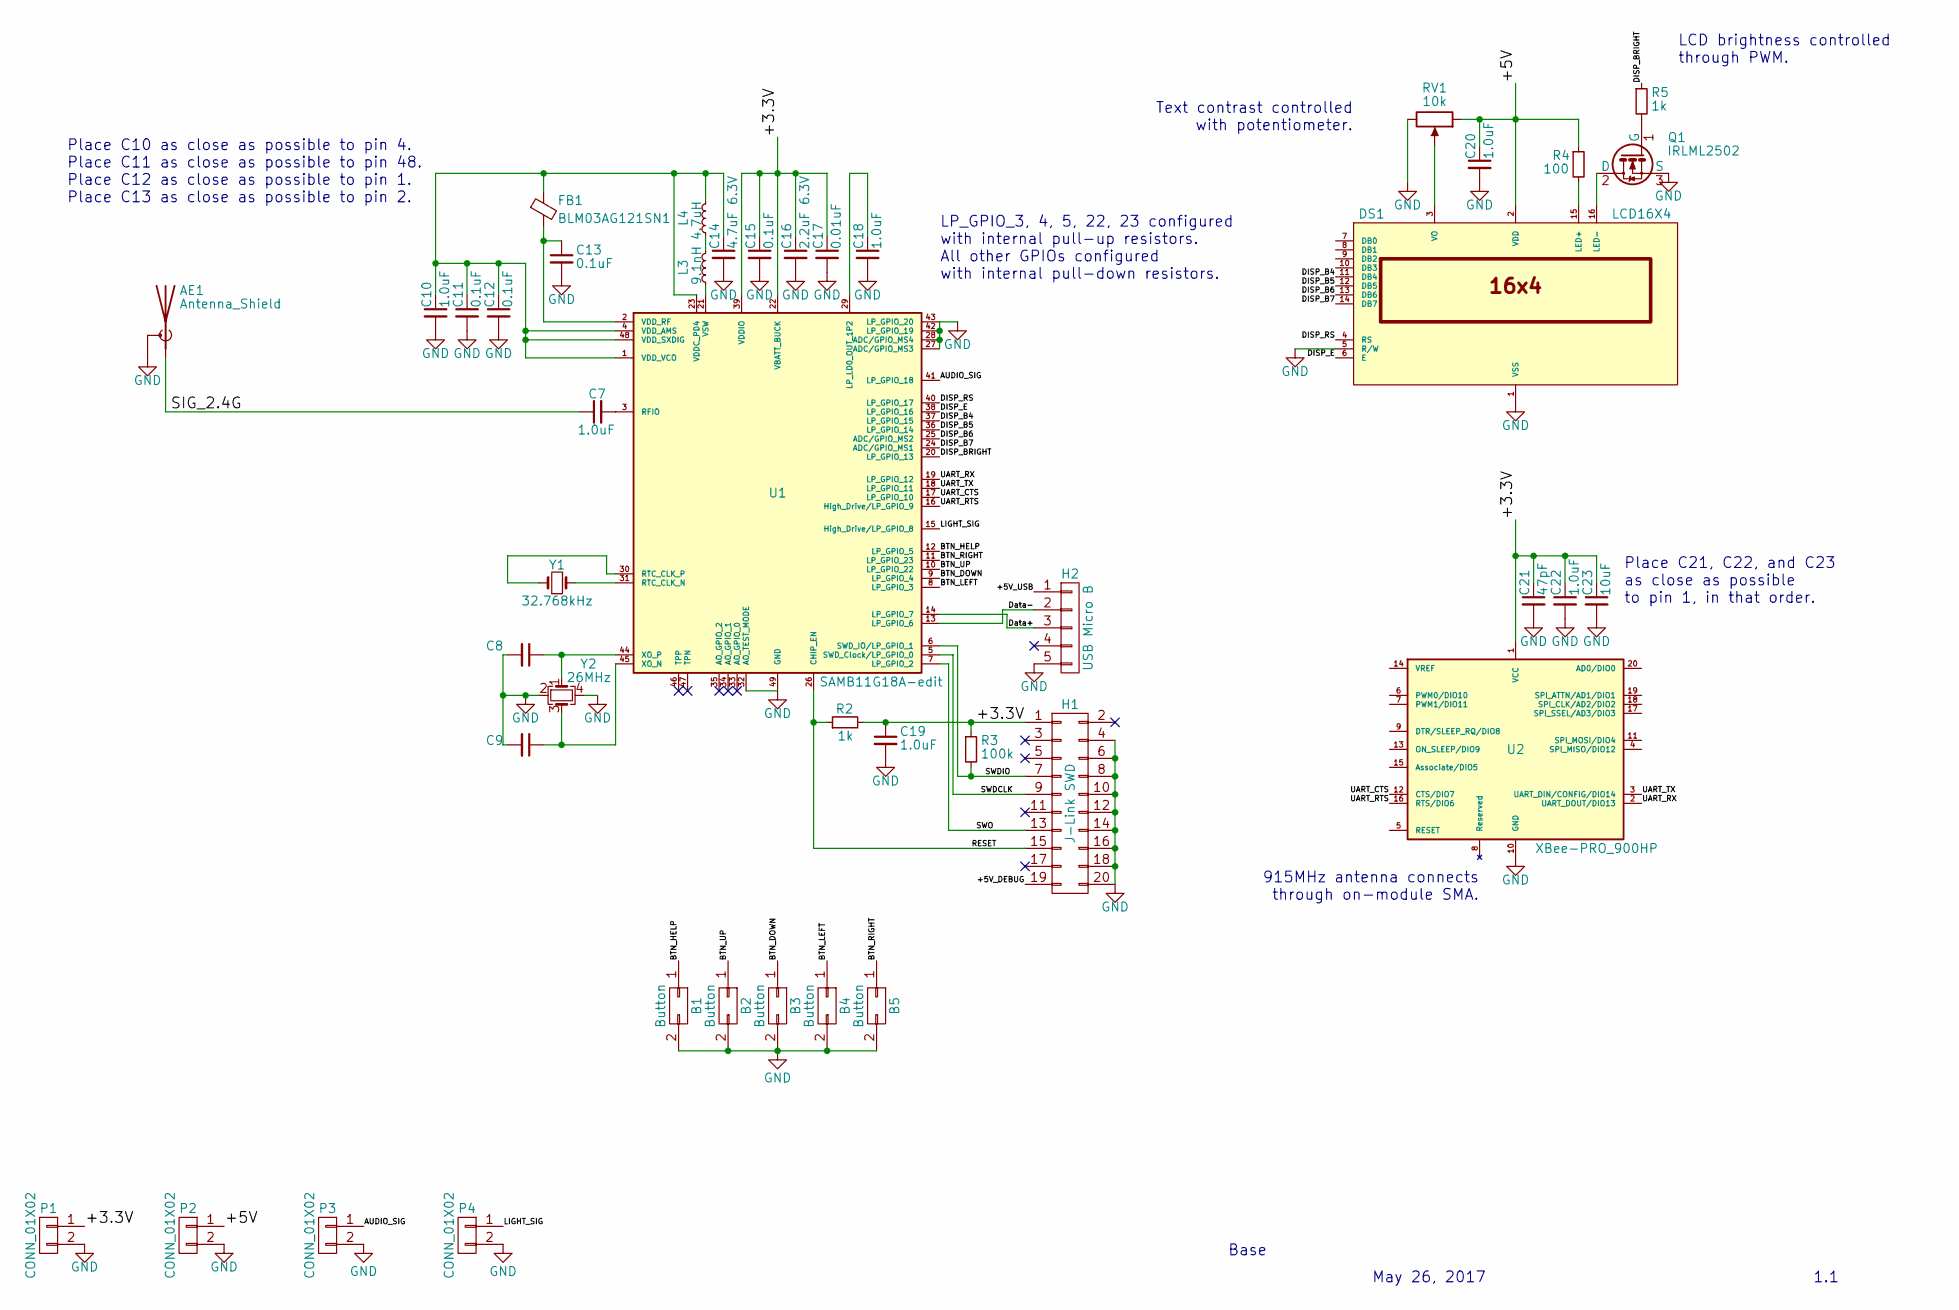
[picture p33: schematic base.sch]

Parts:
AE1: Antenna_Shield; Patch_Antenna_2.4GHz
B1, B2, B3, B4, B5: Button; E-Switch_KS01Q01
C7, C10, C18, C19, C20, C22: 1.0uF; C_0402
C8, C9: C_Small; C_0402
C11, C12, C13, C15: 0.1uF; C_0402
C14: 4.7uF 6.3V; C_0402
C16: 2.2uF 6.3V; C_0402
C17: 0.01uF; C_0402
C21: 47pF; C_0402
C23: 10uF; C_0402
DS1: LCD16X4; CFAH1604A
FB1: BLM03AG121SN1; C_0603_HandSoldering
H1: J-Link SWD; Socket_Strip_Straight_2x10_Pitch2.54mm_Drill0.889mm
H2: USB Micro B; USB_Micro-B_10118194-000XLF
L3: 9.1nH; C_0402
L4: 4.7uH; C_0805_HandSoldering
P1, P2, P3, P4: CONN_01X02; OSTTEXX0164_2pin_3.5mm
Q1: IRLML2502; SOT-23
R2, R5: 1k; C_0402
R3: 100k; C_0402
R4: 100; C_0402
RV1: 10k; Potentiometer_Trimmer_Bourns_3309W
U1: SAMB11G18A-edit; QFN-48-1EP_6x6mm_Pitch0.4mm
U2: XBee-PRO_900HP; Digi_XBee-PRO_TH
Y1: 32.768kHz; Crystal_SMD_3215-2pin_3.2x1.5mm
Y2: 26MHz; Crystal_SMD_3225-4pin_3.2x2.5mm

Connections:
/+3.3V: C15.1, C16.1, C17.1, C19.1, C21.1, C22.1, C23.1, H1.1, P1.1, R2.2, R3.1, U1.22 (VBATT_BUCK), U1.39 (VDDIO), U2.1 (VCC)
/+5V: C20.1, DS1.2 (VDD), P2.1, R4.1, RV1.1
/+5V_DEBUG: H1.19
/+5V_USB: H2.1
/AUDIO_SIG: P3.1, U1.41 (LP_GPIO_18)
/BTN_DOWN: B3.1, U1.9 (LP_GPIO_4)
/BTN_HELP: B1.1, U1.12 (LP_GPIO_5)
/BTN_LEFT: B4.1, U1.8 (LP_GPIO_3)
/BTN_RIGHT: B5.1, U1.11 (LP_GPIO_23)
/BTN_UP: B2.1, U1.10 (LP_GPIO_22)
/DISP_B4: DS1.11 (DB4), U1.37 (LP_GPIO_15)
/DISP_B5: DS1.12 (DB5), U1.36 (LP_GPIO_14)
/DISP_B6: DS1.13 (DB6), U1.25 (ADC/GPIO_MS2)
/DISP_B7: DS1.14 (DB7), U1.24 (ADC/GPIO_MS1)
/DISP_BRIGHT: R5.1, U1.20 (LP_GPIO_13)
/DISP_E: DS1.6 (E), U1.38 (LP_GPIO_16)
/DISP_RS: DS1.4 (RS), U1.40 (LP_GPIO_17)
/Data+: H2.3, U1.14 (LP_GPIO_7)
/Data-: H2.2, U1.13 (LP_GPIO_6)
/LIGHT_SIG: P4.1, U1.15 (High_Drive/LP_GPIO_8)
/RESET: H1.15, R2.1, U1.26 (CHIP_EN)
/SIG_2.4G: AE1.1 (A), C7.1
/SWDCLK: H1.9, U1.5 (SWD_Clock/LP_GPIO_0)
/SWDIO: H1.7, R3.2, U1.6 (SWD_IO/LP_GPIO_1)
/SWO: H1.13, U1.7 (LP_GPIO_2)
/UART_CTS: U1.17 (LP_GPIO_10), U2.12 (CTS/DIO7)
/UART_RTS: U1.16 (High_Drive/LP_GPIO_9), U2.16 (RTS/DIO6)
/UART_RX: U1.19 (LP_GPIO_12), U2.2 (UART_DOUT/DIO13)
/UART_TX: U1.18 (LP_GPIO_11), U2.3 (UART_DIN/CONFIG/DIO14)
GND: AE1.2 (Shield), B1.2, B2.2, B3.2, B4.2, B5.2, C8.2, C9.2, C10.2, C11.2, C12.2, C13.2, C14.2, C15.2, C16.2, C17.2, C18.2, C19.2, C20.2, C21.2, C22.2, C23.2, DS1.1 (VSS), DS1.5 (R/W), H1.4, H1.6, H1.8, H1.10, H1.12, H1.14, H1.16, H1.18, H1.20, H2.5, P1.2, P2.2, P3.2, P4.2, Q1.3 (S), RV1.3, U1.27 (ADC/GPIO_MS3), U1.28 (ADC/GPIO_MS4), U1.32 (AO_TEST_MODE), U1.42 (LP_GPIO_19), U1.43 (LP_GPIO_20), U1.49 (GND), U2.10 (GND), Y2.2, Y2.4
unnamed: C7.2, U1.3 (RFIO)
unnamed: C8.1, U1.44 (XO_P), Y2.1
unnamed: C9.1, U1.45 (XO_N), Y2.3
unnamed: C10.1, C11.1, C12.1, C14.1, FB1.1, L4.2, U1.1 (VDD_VCO), U1.4 (VDD_AMS), U1.23 (VDDC_PD4), U1.48 (VDD_SXDIG)
unnamed: C13.1, FB1.2, U1.2 (VDD_RF)
unnamed: C18.1, U1.29 (LP_LD0_OUT_1P2)
unnamed: DS1.3 (VO), RV1.2
unnamed: DS1.15 (LED+), R4.2
unnamed: DS1.16 (LED-), Q1.2 (D)
unnamed: L3.1, U1.21 (VSW)
unnamed: L3.2, L4.1
unnamed: Q1.1 (G), R5.2
unnamed: U1.30 (RTC_CLK_P), Y1.1
unnamed: U1.31 (RTC_CLK_N), Y1.2

Notes on the sheet:
Base
Place C10 as close as possible to pin 4. Place C11 as close as possible to pin 48. Place C12 as close as possible to pin 1. Place C13 as close as possible to pin 2.
LP_GPIO_3, 4, 5, 22, 23 configured with internal pull-up resistors. All other GPIOs configured with internal pull-down resistors.
Place C21, C22, and C23 as close as possible to pin 1, in that order.
915MHz antenna connects through on-module SMA.
May 26, 2017
1.1
Text contrast controlled with potentiometer.
LCD brightness controlled through PWM.

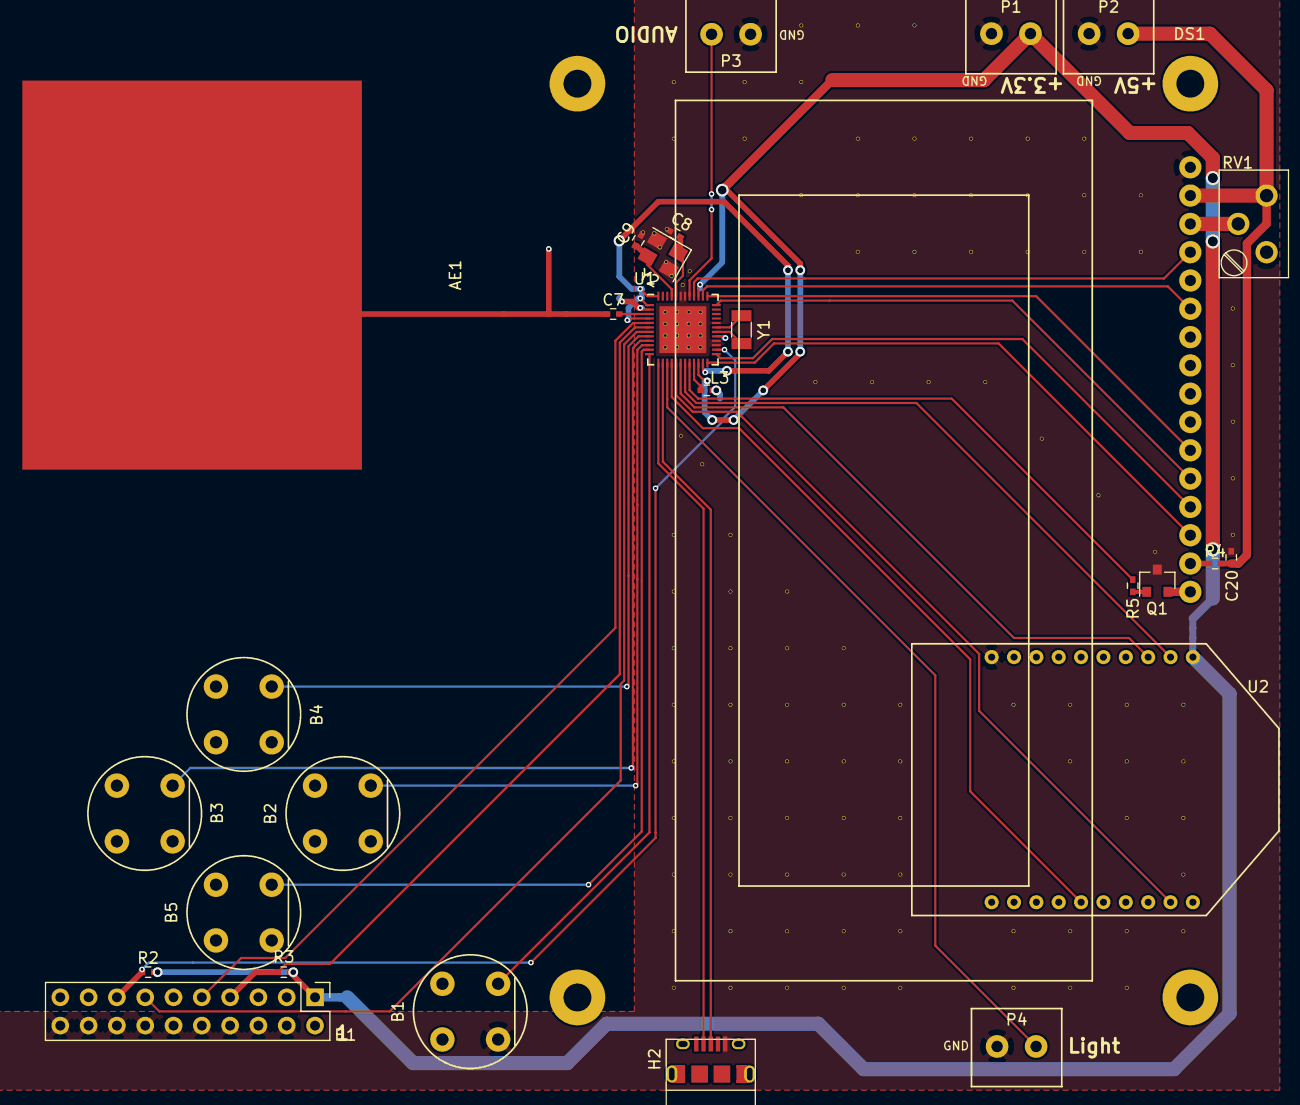
[picture p34: board base.kicad_pcb from above]

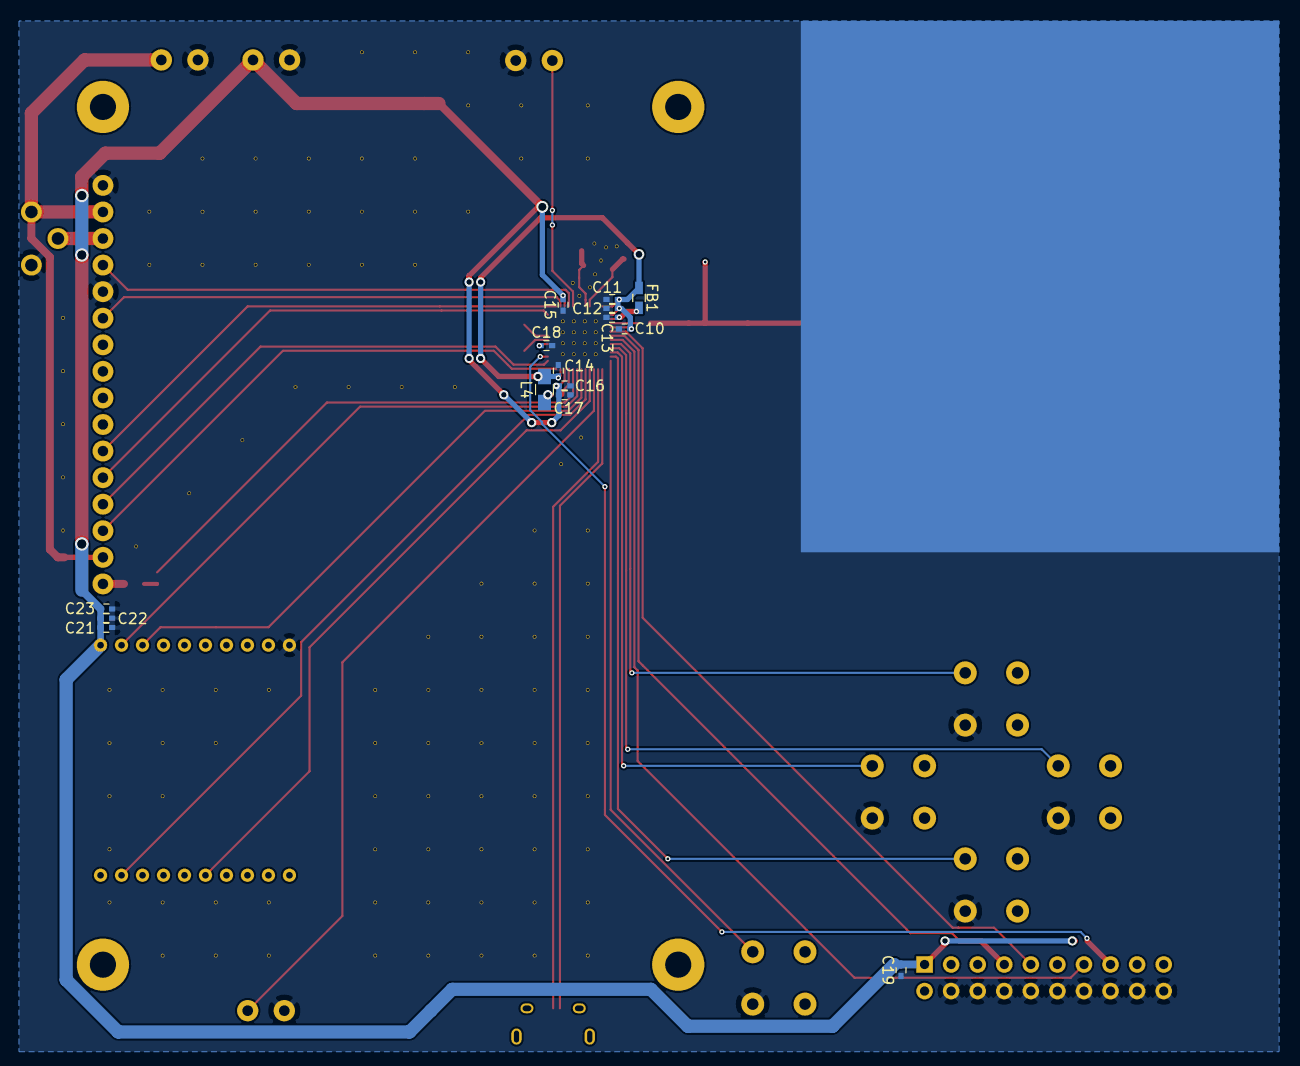
[picture p35: board base.kicad_pcb from below]

Board: 2 copper layers, 43 parts (15 on the bottom side), 42 nets.
