HaHaSDP-UCSC/hahardware/pcb/kicad/power/PowerSupplyV2.kicad_pcb

## KiCad design pcb/kicad/power/PowerSupplyV2.kicad_pcb (2017-06-19)

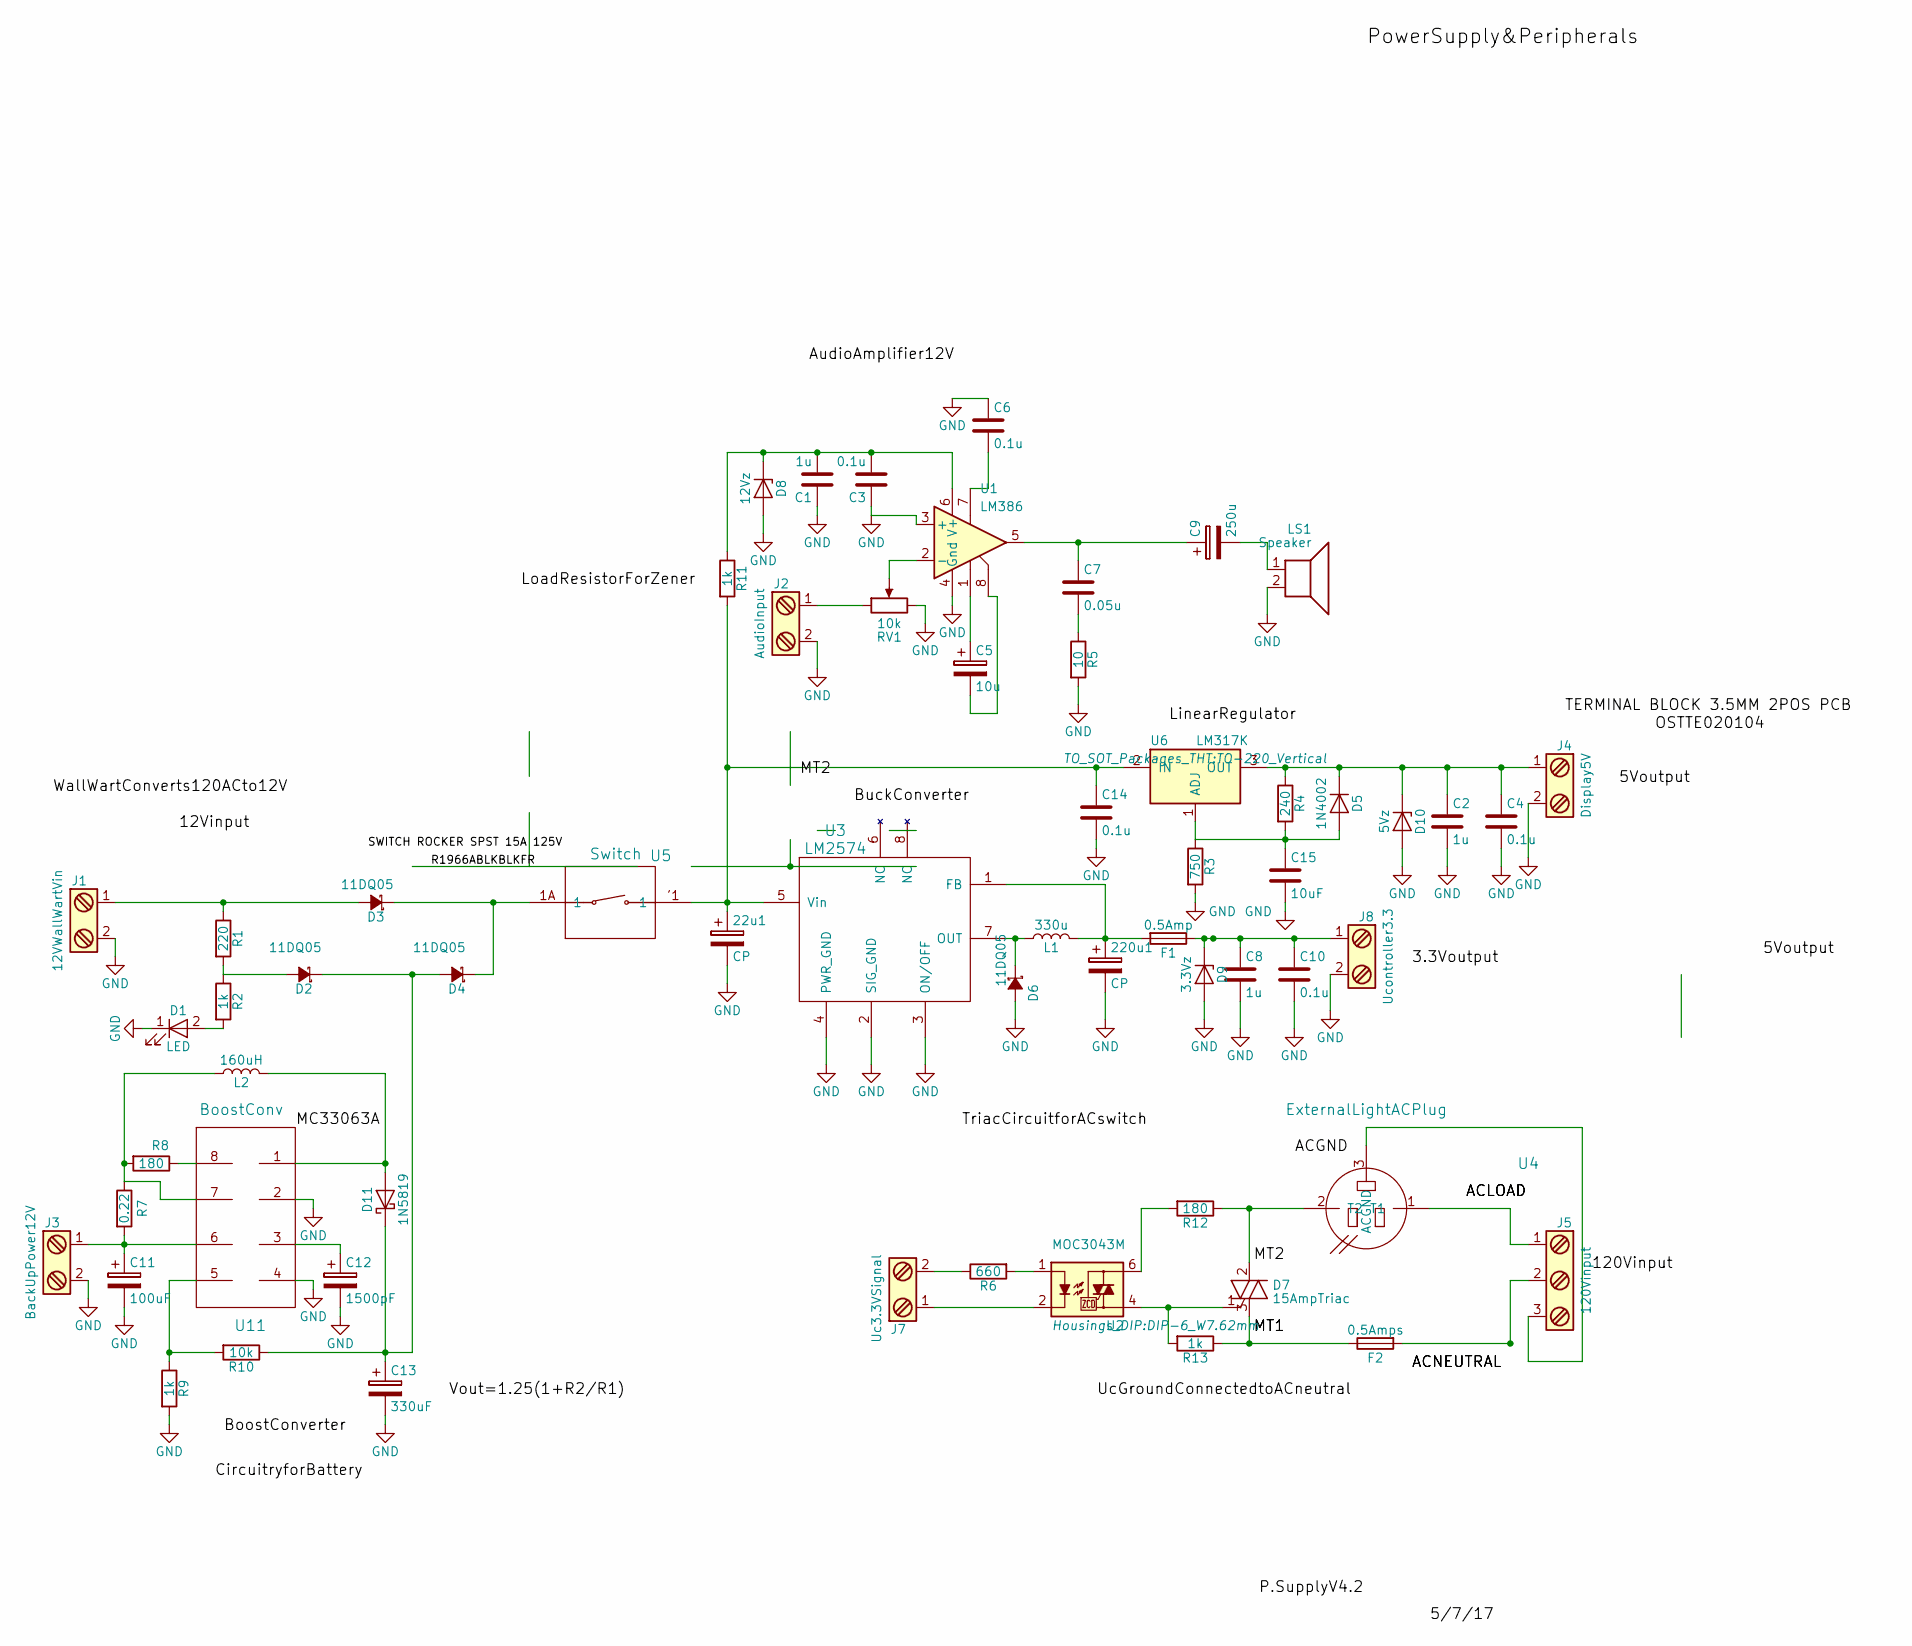
[picture p36: schematic PowerSupplyV2.sch]

Parts:
22u1, 220u1: CP; CP_Radial_D6.3mm_P2.50mm
C1, C2, C8: 1u; R_Axial_DIN0204_L3.6mm_D1.6mm_P7.62mm_Horizontal
C3, C4, C6, C10, C14: 0.1u; R_Axial_DIN0204_L3.6mm_D1.6mm_P7.62mm_Horizontal
C5: 10u; CP_Radial_D6.3mm_P2.50mm
C7: 0.05u; C_0805_HandSoldering
C9: 250u; CP_Radial_D6.3mm_P2.50mm
C11: 100uF; CP_Radial_D6.3mm_P2.50mm
C12: 1500pF; CP_Radial_D6.3mm_P2.50mm
C13: 330uF; CP_Radial_D6.3mm_P2.50mm
C15: 10uF; R_Axial_DIN0204_L3.6mm_D1.6mm_P7.62mm_Horizontal
D1: LED; LED_D5.0mm_Horizontal_O1.27mm_Z3.0mm
D2, D3, D4, D6: 11DQ05; D_DO-15_P5.08mm_Vertical_KathodeUp
D5: 1N4002; D_DO-15_P5.08mm_Vertical_KathodeUp
D7: 15AmpTriac; TO-220_Vertical
D8: 12Vz; D_SOD-323_HandSoldering
D9: 3.3Vz; D_SOD-323_HandSoldering
D10: 5Vz; D_SOT-23_ANK
D11: 1N5819; D_DO-15_P5.08mm_Vertical_KathodeUp
F1: 0.5Amp; FuseTH500mA
F2: 0.5Amps; FuseTH500mA
J1: 12VWallWartVin; BARREL_JACK
J2: AudioInput; BlockTerminal3.5mm
J3: BackUpPower12V; NIMH4.8V
J4: Display5V; BlockTerminal3.5mm
J5: 120Vinput; 703w0053
J7: Uc3.3VSignal; BlockTerminal3.5mm
J8: Ucontroller3.3; BlockTerminal3.5mm
L1: 330u; Choke_SMD_12x12mm_h4.5mm
L2: 160uH; Choke_SMD_12x12mm_h4.5mm
LS1: Speaker; BlockTerminal3.5mm
R1: 220; R_Axial_DIN0309_L9.0mm_D3.2mm_P2.54mm_Vertical
R2, R9, R11, R13: 1k; R_Axial_DIN0309_L9.0mm_D3.2mm_P2.54mm_Vertical
R3: 750; R_Axial_DIN0309_L9.0mm_D3.2mm_P2.54mm_Vertical
R4: 240; R_Axial_DIN0309_L9.0mm_D3.2mm_P2.54mm_Vertical
R5: 10; R_0805_HandSoldering
R6: 660; R_Axial_DIN0309_L9.0mm_D3.2mm_P2.54mm_Vertical
R7: 0.22; R_Axial_DIN0309_L9.0mm_D3.2mm_P2.54mm_Vertical
R8, R12: 180; R_Axial_DIN0309_L9.0mm_D3.2mm_P2.54mm_Vertical
R10: 10k; R_Axial_DIN0309_L9.0mm_D3.2mm_P2.54mm_Vertical
RV1: 10k; Potentiometer_Alps_RK09K_Vertical
U1: LM386; DIP-8_W7.62mm
U2: MOC3043M; DIP-6_W7.62mm
U3: LM2574; PDIP-8
U4: ExternalLightACPlug; 739W-X203
U5: Switch
U6: LM317K; TO-220_Vertical
U11: BoostConv; DIP-8_W7.62mm

Connections:
GND: 22u1.2, 220u1.2, C1.1, C2.2, C3.1, C4.2, C6.1, C8.2, C10.2, C11.2, C12.2, C13.2, C14.2, C15.2, D1.1 (K), D6.2 (A), D8.2 (A), D9.2 (A), D10.2 (A), J1.2, J2.2, J3.2, J4.2, J8.2, LS1.2, R3.2, R5.2, R9.2, RV1.3, U1.3 (+), U1.4 (Gnd), U3.2 (SIG_GND), U3.3 (ON/OFF), U3.4 (PWR_GND), U11.2, U11.4
unnamed: 22u1.1, C14.1, R11.2, U3.5 (Vin), U5.'1, U6.2 (IN)
unnamed: 220u1.1, F1.2, L1.2, U3.1 (FB)
unnamed: C1.2, C3.2, D8.1 (K), R11.1, U1.6 (V+)
unnamed: C2.1, C4.1, D5.1 (K), D10.1 (K), J4.1, R4.1, U6.3 (OUT)
unnamed: C5.1, U1.1
unnamed: C5.2, U1.8
unnamed: C6.2, U1.7
unnamed: C7.1, C9.1, U1.5
unnamed: C7.2, R5.1
unnamed: C9.2, LS1.1
unnamed: C8.1, C10.1, D9.1 (K), F1.1, J8.1
unnamed: C11.1, J3.1, R7.2, U11.6
unnamed: C12.1, U11.3
unnamed: C13.1, D2.1 (K), D4.2 (A), D11.1 (K), R10.1
unnamed: C15.1, D5.2 (A), R3.1, R4.2, U6.1 (ADJ)
unnamed: D1.2 (A), R2.2
unnamed: D2.2 (A), R1.2, R2.1
unnamed: D3.1 (K), D4.1 (K), U5.1A
unnamed: D3.2 (A), J1.1, R1.1
unnamed: D6.1 (K), L1.1, U3.7 (OUT)
unnamed: D7.1 (G), R13.2, U2.4
unnamed: D7.2 (A1), R12.1, U4.2 (T2)
unnamed: D7.3 (A2), F2.1, R13.1
unnamed: D11.2 (A), L2.2, U11.1
unnamed: F2.2, J5.2
unnamed: J2.1, RV1.1
unnamed: J5.1, U4.1 (T1)
unnamed: J5.3, U4.3 (ACGND)
unnamed: J7.1, U2.2
unnamed: J7.2, R6.1
unnamed: L2.1, R7.1, R8.2, U11.7
unnamed: R6.2, U2.1
unnamed: R8.1, U11.8
unnamed: R9.1, R10.2, U11.5
unnamed: R12.2, U2.6
unnamed: RV1.2, U1.2 (-)

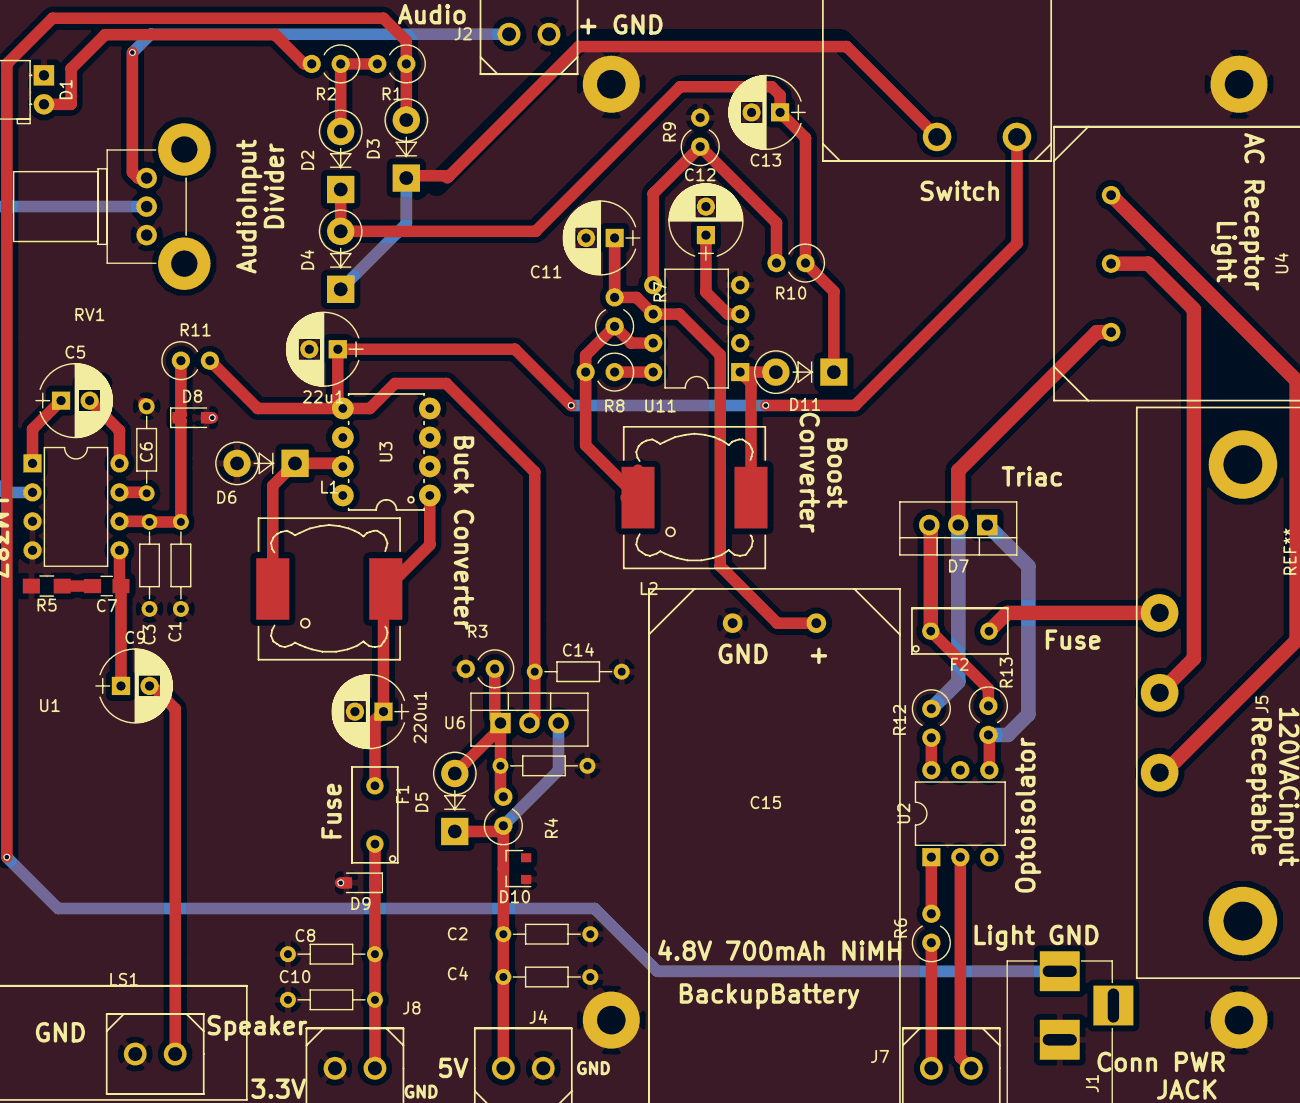
[picture p37: board PowerSupplyV2.kicad_pcb from above]

Board: 2 copper layers, 61 parts (0 on the bottom side), 37 nets.
