HaHaSDP-UCSC/hahardware/pcb/kicad/button/button.kicad_pcb

## KiCad design pcb/kicad/button/button.kicad_pcb (2017-06-19)

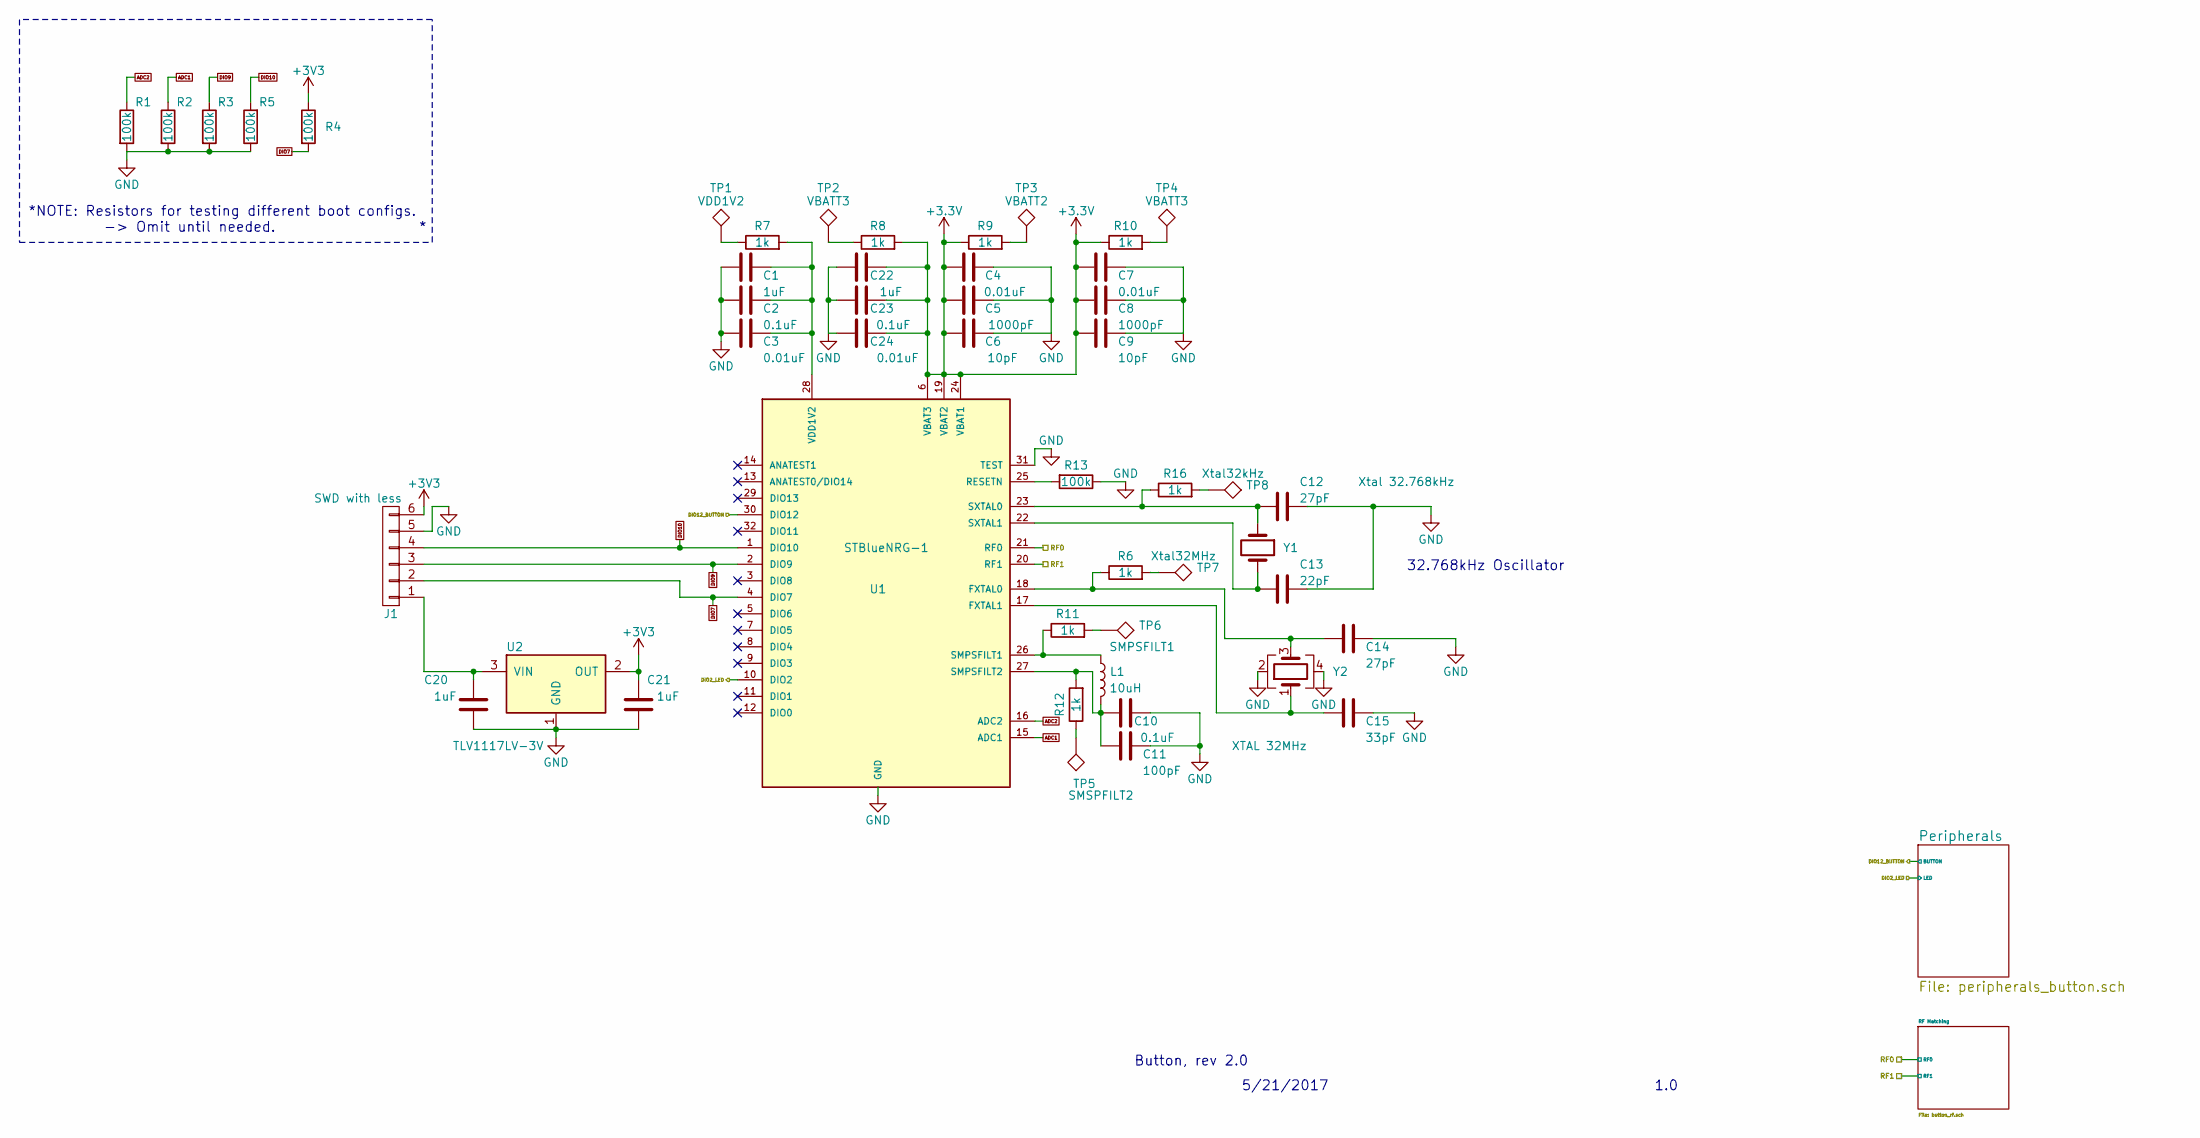
[picture p38: schematic button.sch]

Parts:
C1, C22: 1uF; C_0805
C2, C23: 0.1uF; C_0603
C3, C24: 0.01uF; C_0402
C4, C7: 0.01uF; C_0805
C5, C8: 1000pF; C_0603
C6, C9: 10pF; C_0402
C10: 0.1uF; C_0402
C11: 100pF; C_0402
C12, C14: 27pF; C_0402
C13: 22pF; C_0402
C15: 33pF; C_0402
C20, C21: 1uF; C_0402
J1: SWD with less; Pin_Header_Straight_1x06_Pitch2.54mm
L1: 10uH; Neosid_Inductor_SM-NE29_SMD1008
R1, R2, R3, R4, R5, R13: 100k; R_0402
R6, R9, R11, R12, R16: 1k; R_0402
R7, R8, R10: 1k; R_0603
TP1: VDD1V2; Measurement_Point_Round-SMD-tiniest
TP2, TP4: VBATT3; Measurement_Point_Round-SMD-tiniest
TP3: VBATT2; Measurement_Point_Round-SMD-tiniest
TP5: SMSPFILT2; Measurement_Point_Round-SMD-tiniest
TP6: SMPSFILT1; Measurement_Point_Round-SMD-tiniest
TP7: Xtal32MHz; Measurement_Point_Round-SMD-tiniest
TP8: Xtal32kHz; Measurement_Point_Round-SMD-tiniest
U1: STBlueNRG-1; STBNRG1
U2: TLV1117LV-3V; SOT-223
Y1: Xtal 32.768kHz; Crystal_SMD_3215-2pin_3.2x1.5mm
Y2: XTAL 32MHz; Crystal_SMD_2520-4pin_2.5x2.0mm

Connections:
/DIO2_LED: U1.10 (DIO2); also elsewhere on the board
/DIO12_BUTTON: U1.30 (DIO12); also elsewhere on the board
/RF0: U1.21 (RF0); also elsewhere on the board
/RF1: U1.20 (RF1); also elsewhere on the board
ADC1: R2.1, U1.15 (ADC1)
ADC2: R1.1, U1.16 (ADC2)
DIO7: J1.2, R4.2, U1.4 (DIO7)
DIO9: J1.3, R3.1, U1.2 (DIO9)
DIO10: J1.4, R5.2, U1.1 (DIO10)
GND: C1.2, C2.2, C3.2, C4.2, C5.2, C6.2, C7.1, C8.1, C9.1, C10.2, C11.1, C12.1, C13.1, C14.1, C15.1, C20.1, C21.1, C22.1, C23.1, C24.1, J1.5, R1.2, R2.2, R3.2, R5.1, R13.1, U1.31 (TEST), U1.33 (GND), U2.1 (GND), Y2.2, Y2.4; also elsewhere on the board
unnamed: C1.1, C2.1, C3.1, R7.2, U1.28 (VDD1V2)
unnamed: C10.1, C11.2, L1.2, R12.2, U1.27 (SMPSFILT2)
unnamed: C12.2, R16.1, U1.23 (SXTAL0), Y1.1
unnamed: C13.2, U1.22 (SXTAL1), Y1.2
unnamed: C14.2, R6.1, U1.18 (FXTAL0), Y2.3
unnamed: C15.2, U1.17 (FXTAL1), Y2.1
unnamed: C20.2, J1.1, U2.3 (VIN)
unnamed: L1.1, R11.1, U1.26 (SMPSFILT1)
unnamed: R6.2, TP7.1
unnamed: R7.1, TP1.1
unnamed: R8.1, TP2.1
unnamed: R9.2, TP3.1
unnamed: R10.2, TP4.1
unnamed: R11.2, TP6.1
unnamed: R12.1, TP5.1
unnamed: R13.2, U1.25 (RESETN)
unnamed: R16.2, TP8.1

Notes on the sheet:
Button, rev 2.0
1.0
5/21/2017
32.768kHz Oscillator
*NOTE: Resistors for testing different boot configs. -> Omit until needed. *

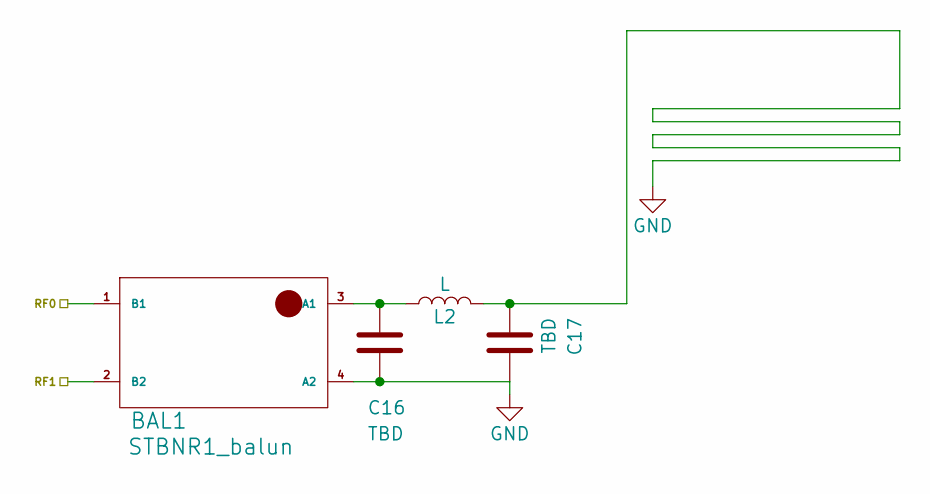
[picture p39: schematic button_rf.sch]

Parts:
BAL1: STBNR1_balun; BNRG1_balun
C16, C17: TBD; C_0402
L2: L; C_0603_HandSoldering

Connections:
/RF0: BAL1.1 (B1); also elsewhere on the board
/RF1: BAL1.2 (B2); also elsewhere on the board
GND: BAL1.4 (A2), C16.2, C17.1, C17.2, L2.2; also elsewhere on the board
unnamed: BAL1.3 (A1), C16.1, L2.1

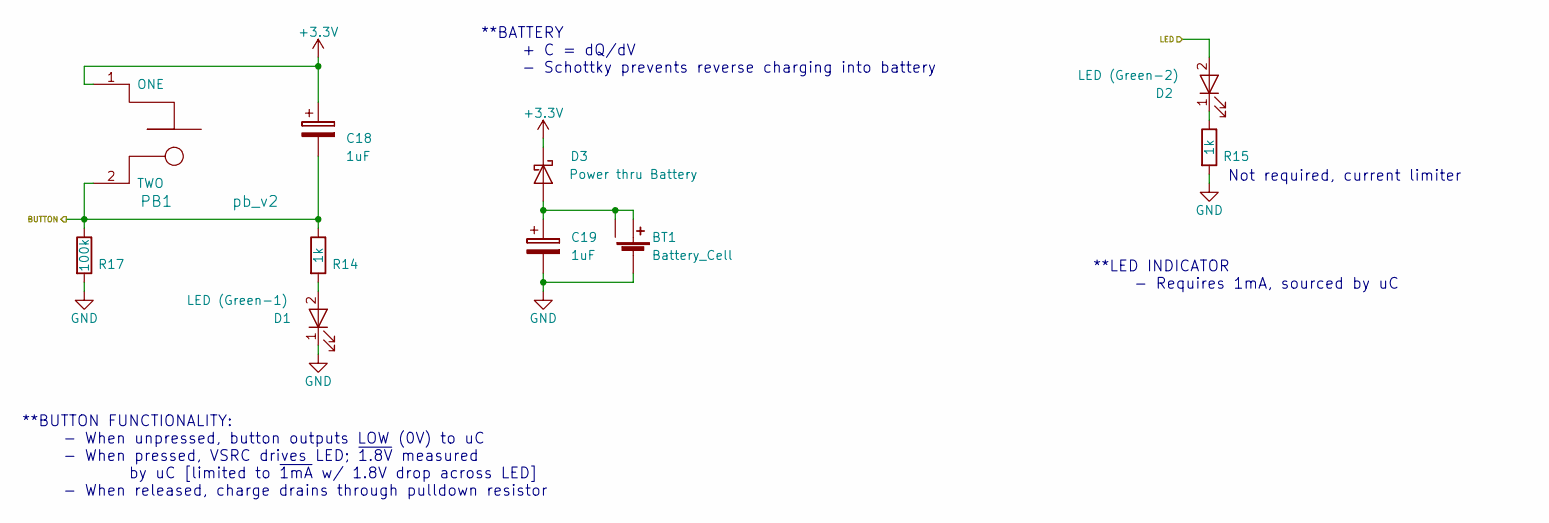
[picture p40: schematic peripherals_button.sch]

Parts:
BT1: Battery_Cell; CoinCell_holder_1060x630
C18, C19: 1uF; C_0603_HandSoldering
D1: LED (Green-1); LED_0402
D2: LED (Green-2); LED_0402
D3: Power thru Battery; D_0603
PB1: pb_v2; SW_PUSH-12mm
R14, R15: 1k; R_0402
R17: 100k; R_0402

Connections:
/DIO2_LED: D2.2 (A); also elsewhere on the board
/DIO12_BUTTON: C18.2, PB1.2 (TWO), R14.1, R17.1; also elsewhere on the board
GND: BT1.3 (-), C19.2, D1.1 (K), R15.2, R17.2; also elsewhere on the board
unnamed: BT1.1 (+), BT1.2 (++), C19.1, D3.2 (A)
unnamed: D1.2 (A), R14.2
unnamed: D2.1 (K), R15.1

Notes on the sheet:
**BUTTON FUNCTIONALITY: - When unpressed, button outputs LOW (0V) to uC - When pressed, VSRC drives LED; ~1.8V measured by uC [limited to ~1mA w/ 1.8V drop across LED] - When released, charge drains through pulldown resistor
**BATTERY + C = dQ/dV - Schottky prevents reverse charging into battery
**LED INDICATOR - Requires 1mA, sourced by uC
Not required, current limiter

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
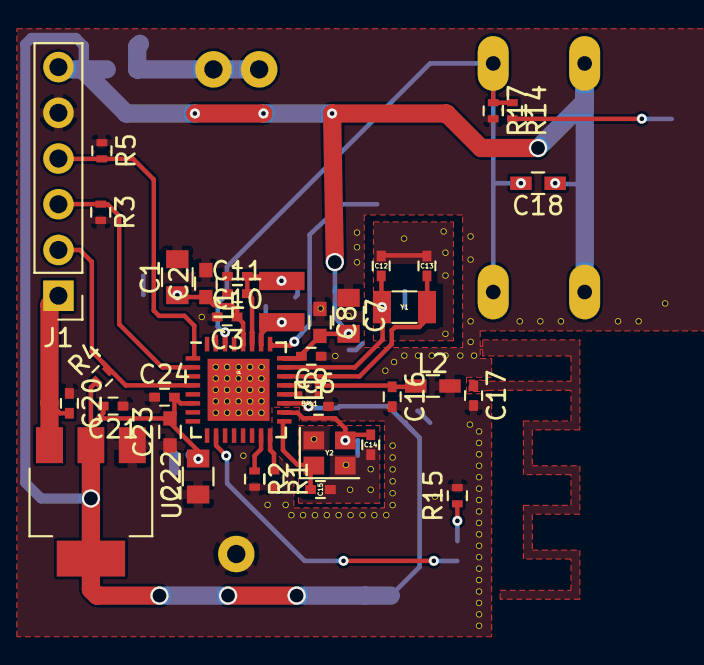
[picture p41: board button.kicad_pcb from above]

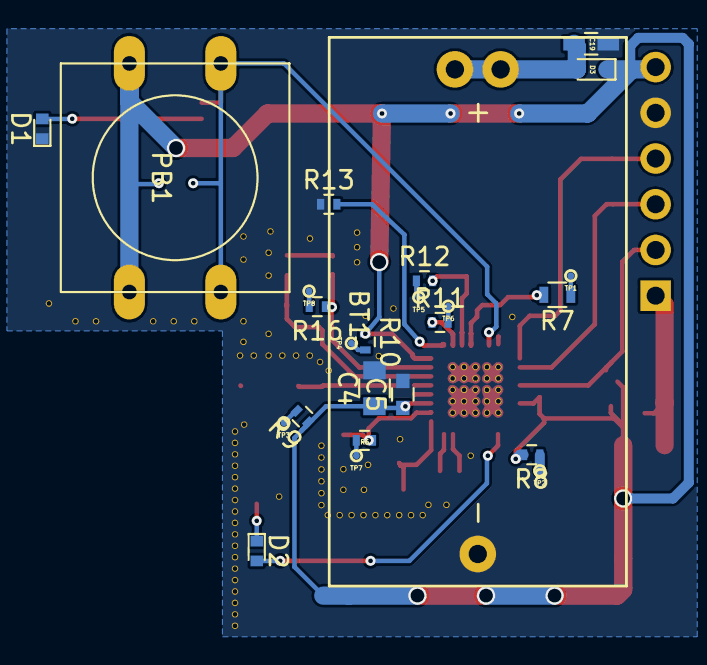
[picture p42: board button.kicad_pcb from below]

Board: 2 copper layers, 62 parts (25 on the bottom side), 32 nets.
