HaHaSDP-UCSC/hahardware/pcb/kicad/antenna/900mhz/915 PCB Antenna 01/915 PCB Antenna 01.kicad_pcb

## KiCad design pcb/kicad/antenna/900mhz/915 PCB Antenna 01/915 PCB Antenna 01.kicad_pcb (2017-06-19)

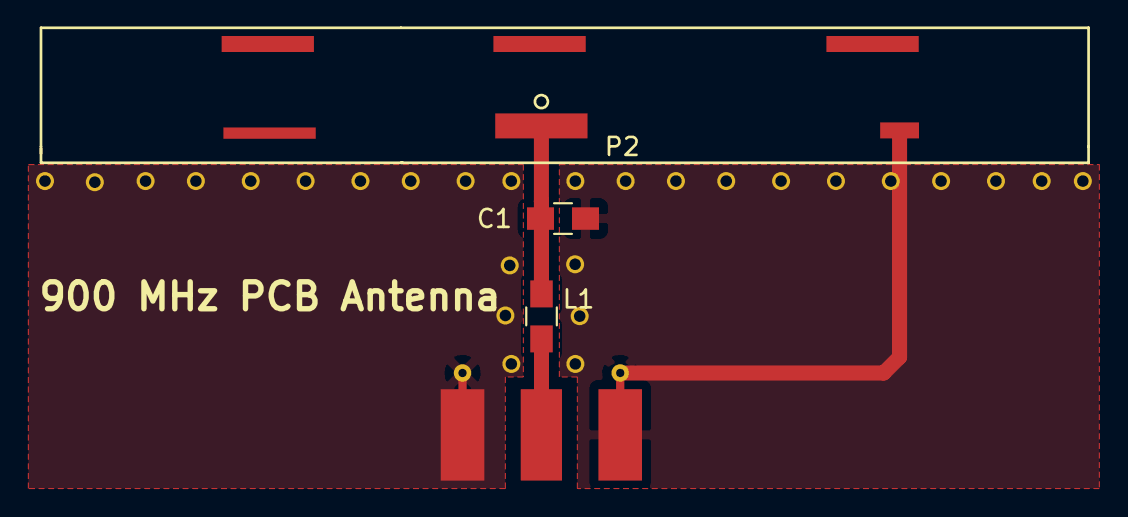
[picture p43: board 915 PCB Antenna 01.kicad_pcb from above]

Board: 2 copper layers, 4 parts (0 on the bottom side), 3 nets.

Parts:
C1: 13pF; C_0805_HandSoldering
L1: 7.5nH; C_0805_HandSoldering
P1: CONN_01X02; Molex_SMA_Jack_Edge_Mount
P2: CONN_01X02; 915 PCB Antenna 01

Connections:
GND: C1.2, P1.2, P2.2
unnamed: C1.1, L1.1, P2.1
unnamed: L1.2, P1.1
