HaHaSDP-UCSC/hahardware/pcb/kicad/antenna/2.4ghz/patch_balun/patch_balun.kicad_pcb

## KiCad design pcb/kicad/antenna/2.4ghz/patch_balun/patch_balun.kicad_pcb (2017-06-19)

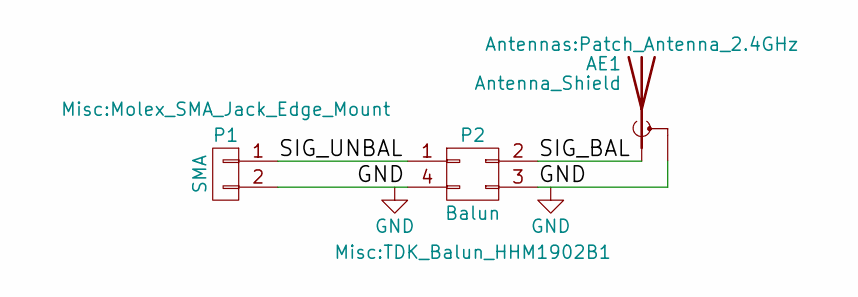
[picture p44: schematic patch_balun.sch]

Parts:
AE1: Antenna_Shield; Patch_Antenna_2.4GHz
P1: SMA; Molex_SMA_Jack_Edge_Mount
P2: Balun; TDK_Balun_HHM1902B1

Connections:
/SIG_BAL: AE1.1 (A), P2.2
/SIG_UNBAL: P1.1, P2.1
GND: AE1.2 (Shield), P1.2, P2.3, P2.4

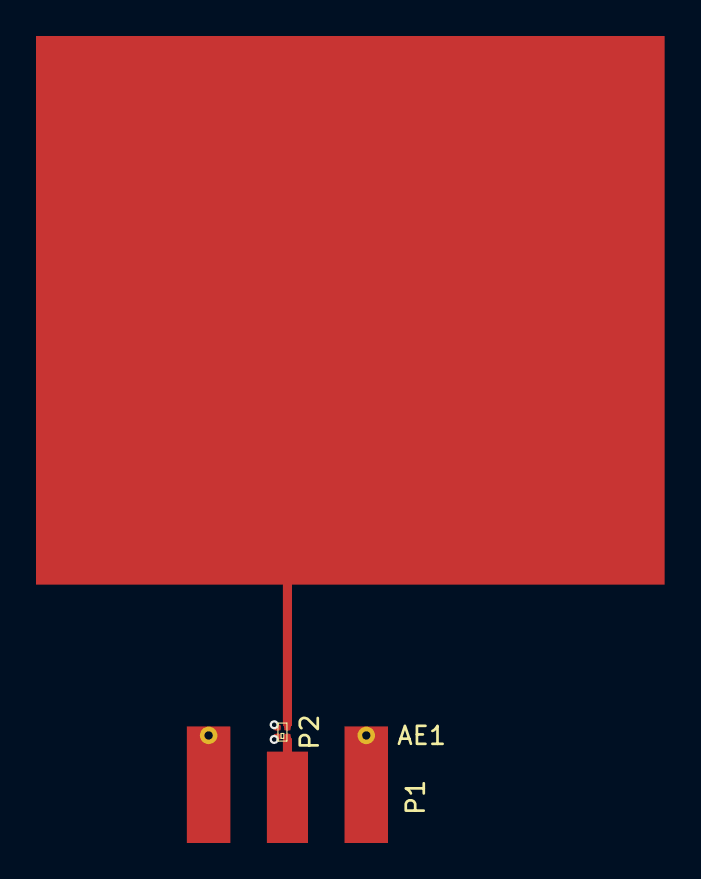
[picture p45: board patch_balun.kicad_pcb from above]

Board: 2 copper layers, 3 parts (0 on the bottom side), 3 nets.
