HaHaSDP-UCSC/hahardware/pcb/kicad/peripherals/audio/AudioAmpLM386.kicad_pcb

## KiCad design pcb/kicad/peripherals/audio/AudioAmpLM386.kicad_pcb (2017-06-19)

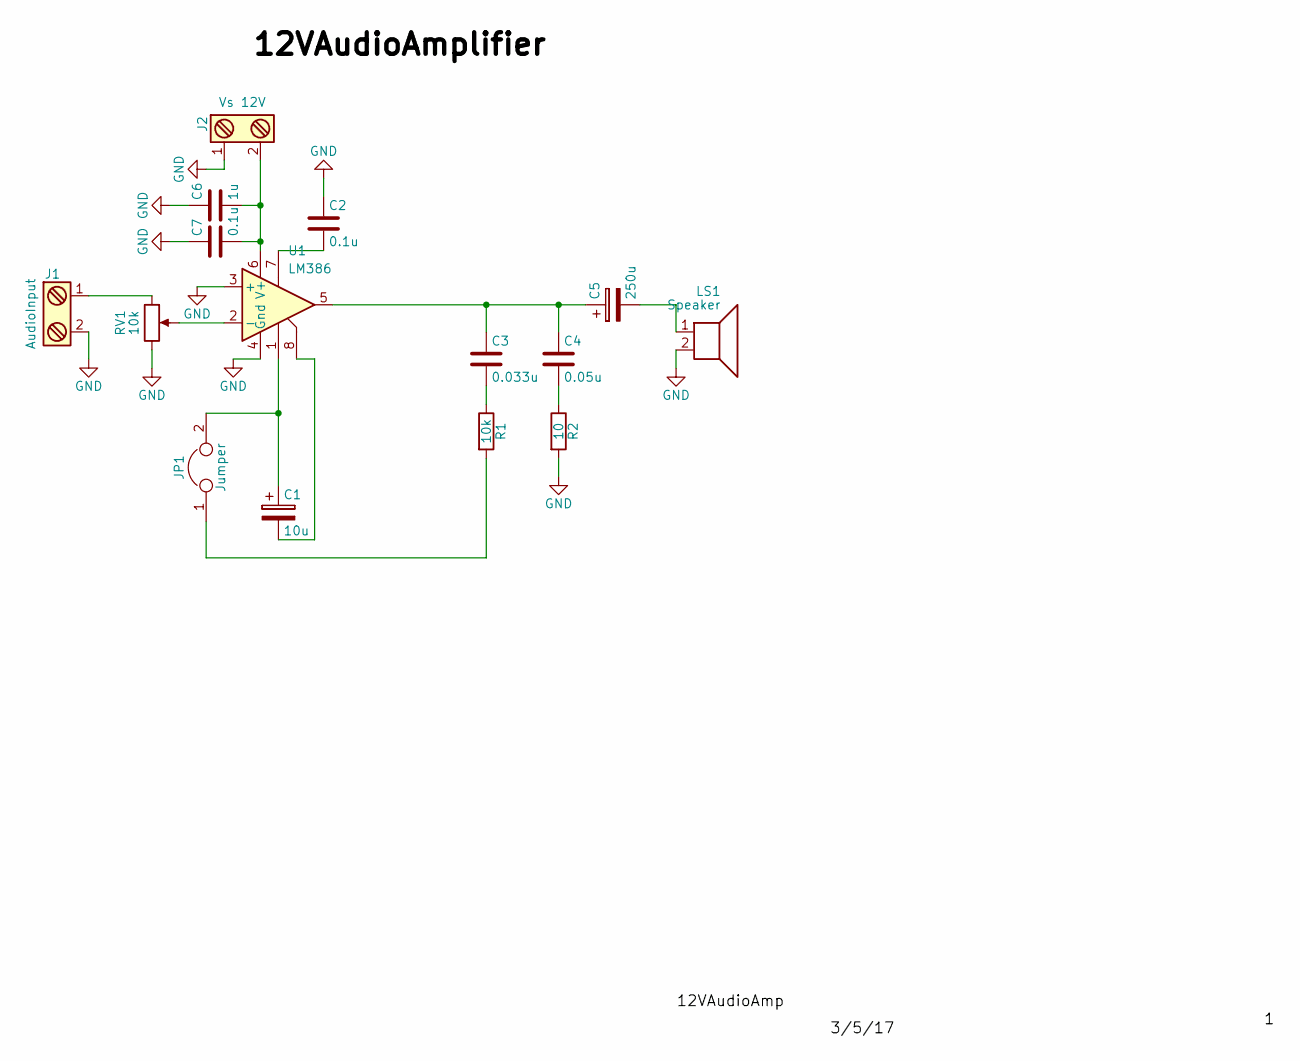
[picture p46: schematic AudioAmpLM386.sch]

Parts:
C1: 10u; CP_Elec_5x4.5
C2, C7: 0.1u; C_0603_HandSoldering
C3: 0.033u; C_0805_HandSoldering
C4: 0.05u; C_0805_HandSoldering
C5: 250u; CP_Elec_10x10
C6: 1u; C_0805_HandSoldering
J1: AudioInput; Pin_Header_Straight_1x02_Pitch2.54mm
J2: Vs 12V; Pin_Header_Straight_1x02_Pitch2.54mm
JP1: Jumper; Pin_Header_Straight_1x02_Pitch2.54mm
LS1: Speaker; Pin_Header_Straight_1x02_Pitch2.54mm
R1: 10k; R_0805_HandSoldering
R2: 10; R_0805_HandSoldering
RV1: 10k; Potentiometer_Alps_RK09K_Horizontal
U1: LM386; DIP-8_W7.62mm

Connections:
GND: C2.1, C6.1, C7.1, J1.2, J2.1, LS1.2, R2.2, RV1.3, U1.3 (+), U1.4 (Gnd)
unnamed: C1.1, JP1.2, U1.1
unnamed: C1.2, U1.8
unnamed: C2.2, U1.7
unnamed: C3.1, C4.1, C5.1, U1.5
unnamed: C3.2, R1.1
unnamed: C4.2, R2.1
unnamed: C5.2, LS1.1
unnamed: C6.2, C7.2, J2.2, U1.6 (V+)
unnamed: J1.1, RV1.1
unnamed: JP1.1, R1.2
unnamed: RV1.2, U1.2 (-)

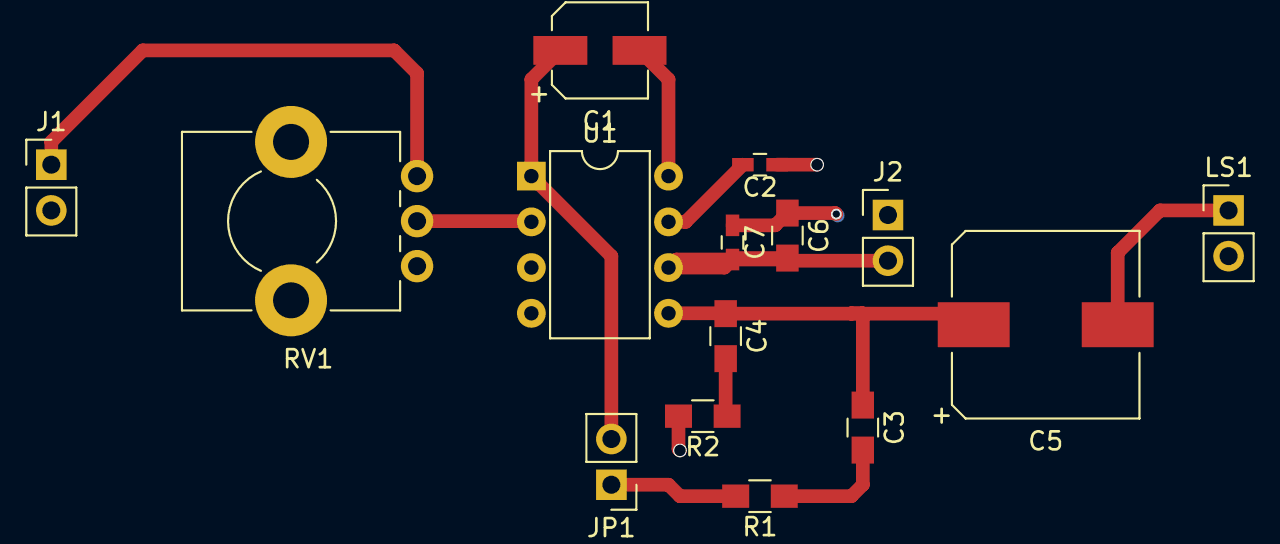
[picture p47: board AudioAmpLM386.kicad_pcb from above]

Board: 2 copper layers, 15 parts (0 on the bottom side), 12 nets.
