HaHaSDP-UCSC/hahardware/pcb/kicad/antenna/2.4ghz/chip/antenova/rufa.kicad_pcb

## KiCad design pcb/kicad/antenna/2.4ghz/chip/antenova/rufa.kicad_pcb (2017-06-19)

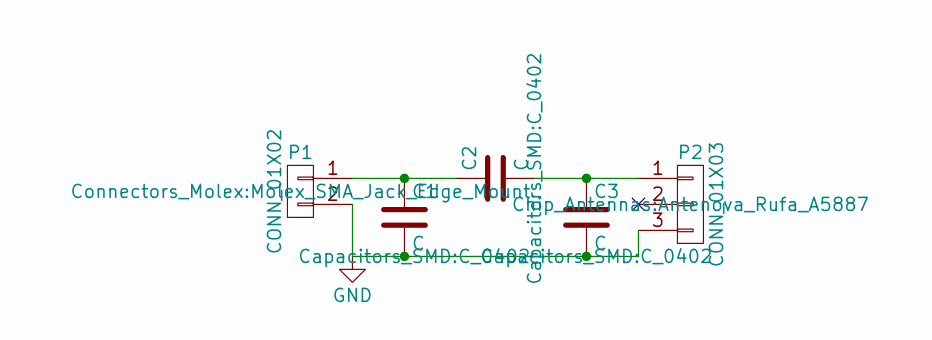
[picture p48: schematic rufa.sch]

Parts:
C1, C2, C3: C; C_0402
P1: CONN_01X02; Molex_SMA_Jack_Edge_Mount
P2: CONN_01X03; Antenova_Rufa_A5887

Connections:
GND: C1.2, C3.2, P1.2, P2.3
unnamed: C1.1, C2.1, P1.1
unnamed: C2.2, C3.1, P2.1

Board: 2 copper layers, 5 parts (0 on the bottom side), 3 nets, no tracks yet.
