HaHaSDP-UCSC/hahardware/pcb/kicad/peripherals/light/LED5mmArray12V.kicad_pcb

## KiCad design pcb/kicad/peripherals/light/LED5mmArray12V.kicad_pcb (2017-06-19)

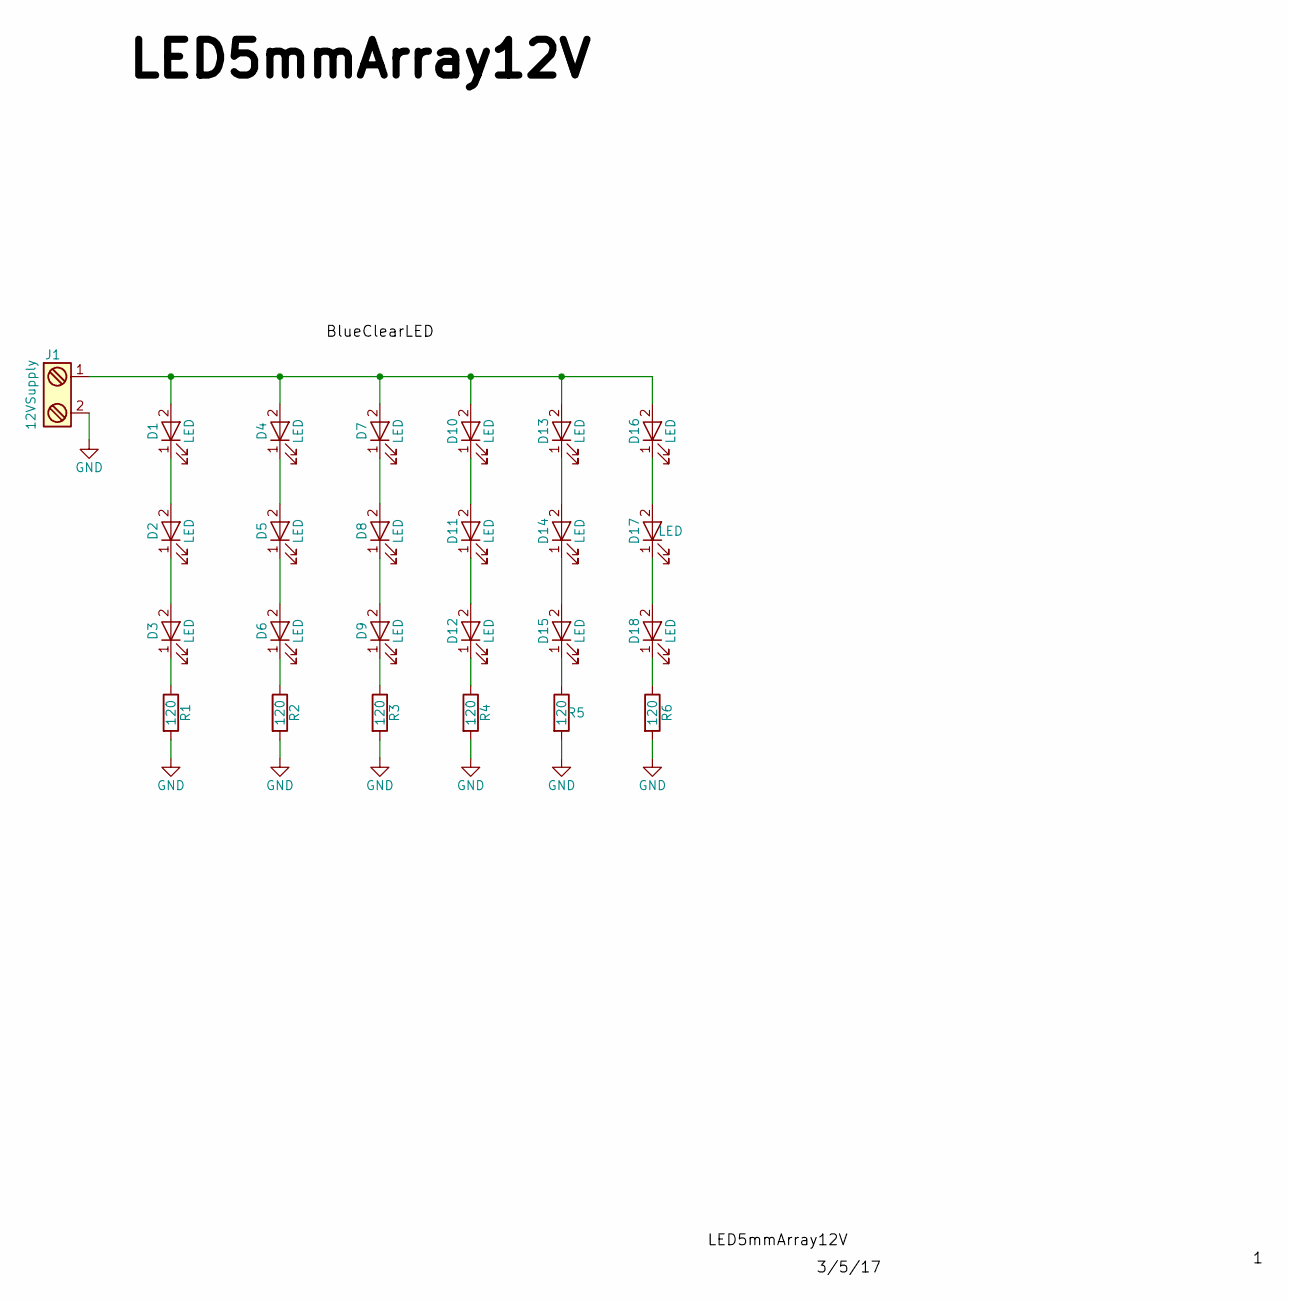
[picture p49: schematic LED5mmArray12V.sch]

Parts:
D1, D2, D3, D4, D5, D6, D7, D8, D9, D10, D11, D12, D13, D14, D15, D16, D17, D18: LED; LED_D5.0mm
J1: 12VSupply; Pin_Header_Straight_1x02_Pitch2.54mm
R1, R2, R3, R4, R5, R6: 120; R_0603_HandSoldering

Connections:
GND: J1.2, R1.2, R2.2, R3.2, R4.2, R5.2, R6.2
unnamed: D1.1 (K), D2.2 (A)
unnamed: D1.2 (A), D4.2 (A), D7.2 (A), D10.2 (A), D13.2 (A), D16.2 (A), J1.1
unnamed: D2.1 (K), D3.2 (A)
unnamed: D3.1 (K), R1.1
unnamed: D4.1 (K), D5.2 (A)
unnamed: D5.1 (K), D6.2 (A)
unnamed: D6.1 (K), R2.1
unnamed: D7.1 (K), D8.2 (A)
unnamed: D8.1 (K), D9.2 (A)
unnamed: D9.1 (K), R3.1
unnamed: D10.1 (K), D11.2 (A)
unnamed: D11.1 (K), D12.2 (A)
unnamed: D12.1 (K), R4.1
unnamed: D13.1 (K), D14.2 (A)
unnamed: D14.1 (K), D15.2 (A)
unnamed: D15.1 (K), R5.1
unnamed: D16.1 (K), D17.2 (A)
unnamed: D17.1 (K), D18.2 (A)
unnamed: D18.1 (K), R6.1

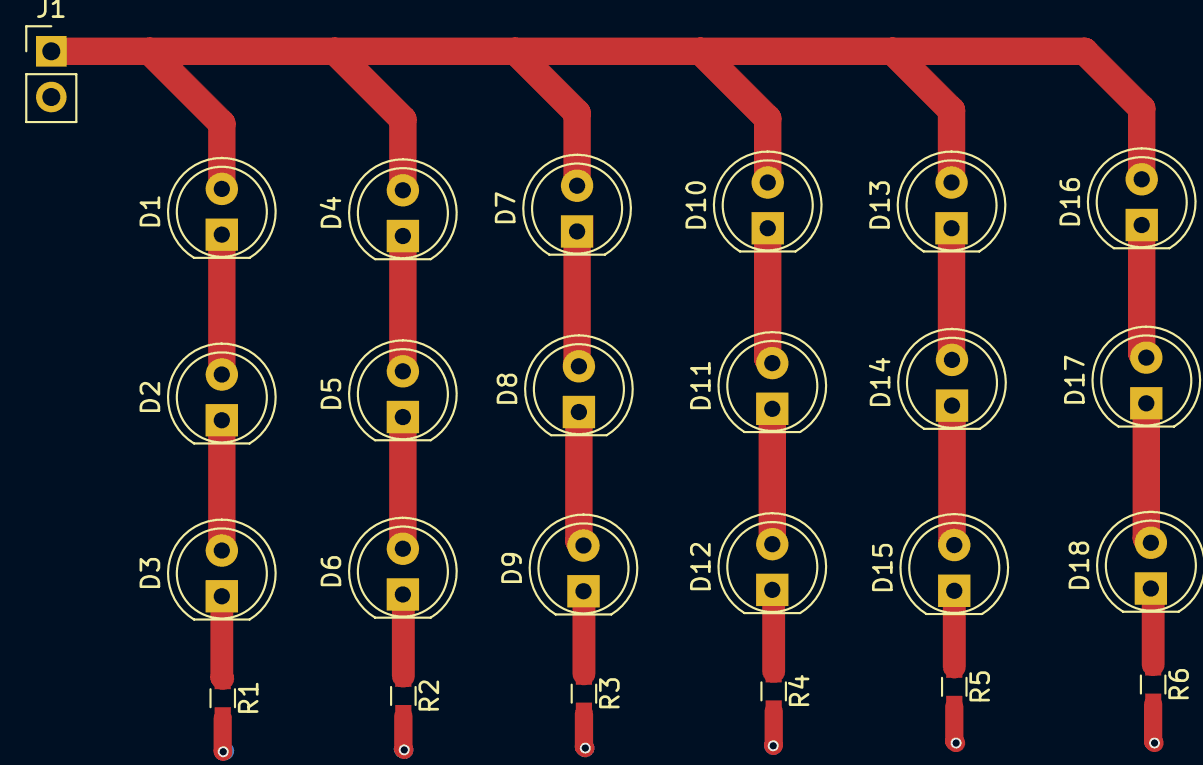
[picture p50: board LED5mmArray12V.kicad_pcb from above]

Board: 2 copper layers, 25 parts (0 on the bottom side), 20 nets.
