HaHaSDP-UCSC/hahardware/(commit log)

2017-06-19 Add datasheets and appnotes up to end of week 4
    Rough power budget and symbol start for MK31Z included.
    [base-power_budget.xlsx, base.sch]
2017-06-19 Add appnotes and fix power budget
    New application notes related to uC quiescent current and PCB antennas
    added. Power budget now includes current and power draw for two new
    uC-radio configurations.
    [base-power_budget.xlsx]
2017-06-19 Fix modes in power budget and add more appnotes
    Power budget now clearly defines typical, low, and max power using
    appropriate operation modes defined by datasheets. More appnotes related
    to PCB antenna design and chip antennas added.
    [base-power_budget.xlsx]
2017-06-19 Cleanup and add antenna appnotes
    New appnotes and research papers discussing different patch antenna
    designs.
2017-06-19 Fix power budget with speaker specs
    [base-power_budget.xlsx]
2017-06-19 Add initial patch antenna design
    Rough calculations and layout for first patch antenna design test board
    finished.
    [patch-B.Cu.gbr, patch-B.Mask.gbr, patch-B.SilkS.gbr, patch-F.Cu.gbr, patch-F.Mask.gbr, patch-F.SilkS.gbr, patch-drl_map.gbr, patch.drl]
2017-06-19 Add notes to calculations
    [patch_antenna-calculations.xlsx]
2017-06-19 Add pdf and archive of initial design
    [patch.kicad_pcb]
2017-06-19 Cleanup layout, files, and calculations
    [patch-B.Cu.gbr, patch-B.Mask.gbr, patch-B.SilkS.gbr, patch-Edge.Cuts.gbr, patch-F.Cu.gbr, patch-F.Mask.gbr, patch-F.SilkS.gbr, patch-Margin.gbr]
2017-06-19 Add first half of initial IFA design
    F portion of antenna layed out. Ground plane still to be completed.
    [ifa-calculations.xlsx, ifa.kicad_pcb, ifa.sch]
2017-06-19 Add second half of initial IFA design
    Vias, drills, and padding still need to be configured.
    [ifa-calculations.xlsx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]
2017-06-19 Cleanup vias on layout
    Layout is essentially complete, but concerned about the lack of physical
    connection between SMA signal and antenna feedline. Further attempts,
    especially fill, to fix this introduced more problems with the rest of
    the layout.
    [ifa-B.Cu.gbr, ifa-B.Mask.gbr, ifa-B.SilkS.gbr, ifa-Edge.Cuts.gbr, ifa-F.Cu.gbr, ifa-F.Mask.gbr, ifa-F.SilkS.gbr, ifa-Margin.gbr]
2017-06-19 Cleanup copper layer and cut marks
    SMA connector now properly connects to the feedline with no breaks. Vias
    do not keep their "ground" net if you leave the application and return
    at a latter time; workaround has not been found. Extra vias may need to
    be placed along the ground plane.
    [ifa-B.Cu.gbr, ifa-B.Mask.gbr, ifa-B.SilkS.gbr, ifa-Edge.Cuts.gbr, ifa-F.Cu.gbr, ifa-F.Mask.gbr, ifa-F.SilkS.gbr, ifa-Margin.gbr]
2017-06-19 Cleanup preferences and minor aesthetics
    [ifa-B.Cu.gbr, ifa-B.Mask.gbr, ifa-B.SilkS.gbr, ifa-Edge.Cuts.gbr, ifa-F.Cu.gbr, ifa-F.Mask.gbr, ifa-F.SilkS.gbr, ifa-Margin.gbr]
2017-06-19 Fix via locations
    Vias now placed with a finer resolution of 0.5 mils instead of 1 mils.
    [ifa-B.Cu.gbr, ifa-B.Mask.gbr, ifa-B.SilkS.gbr, ifa-Edge.Cuts.gbr, ifa-F.Cu.gbr, ifa-F.Mask.gbr, ifa-F.SilkS.gbr, ifa-Margin.gbr]
2017-06-19 Add complete layout for simple IFA
    [ifa_simple-B.Cu.gbr, ifa_simple-B.Mask.gbr, ifa_simple-B.SilkS.gbr, ifa_simple-Edge.Cuts.gbr, ifa_simple-F.Cu.gbr, ifa_simple-F.Mask.gbr, ifa_simple-F.SilkS.gbr, ifa_simple-Margin.gbr]
2017-06-19 Add initial PCB tiling
    [patch-B.Cu.gbr, patch-B.Mask.gbr, patch-F.Cu.gbr, patch-F.Mask.gbr, patch-F.SilkS.gbr, patch-Margin.gbr, r0.1.drl]
2017-06-19 Cleanup gerber layer order
    Vias have been added to both IFA antenna layouts. Initial power supply
    and first MIFA layout have been finished, but only the power supply
    has been tiled onto the board house order. First MIFA KiCad files
    currently missing. The tile gerber file had its artwork layers
    reorganized.
    [KidCadProject1.01-B.Cu.gbr, KidCadProject1.01-B.Mask.gbr, KidCadProject1.01-B.SilkS.gbr, KidCadProject1.01-F.Cu.gbr, KidCadProject1.01-F.Mask.gbr, KidCadProject1.01-F.SilkS.gbr, KidCadProject1.01-Margin.gbr, KidCadProject1.01-drl_map.gbr]
2017-06-19 Fix via and CPWG calculations
    [ifa-calculations.xlsx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]
2017-06-19 Add tiling for both MIFAs
    [CC2511_USB_Dongle_1_3.pcb, IFA_USB.dxf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]
2017-06-19 Add datasheets on chip antennas
    More datasheets for well-performing antennas from both Johanson and
    Antenova added. A couple appnotes for dipole and balun design included.
2017-06-19 Add complete layout for Rufa chip antenna
    Footprints for Antenova Rufa chip antenna and stitch via completed.
    [chip_antenova_rufa-calculations.xlsx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]
2017-06-19 Add final tiling for first revision test board
    Tiled the remainder of the MIFA antennas as well as two antennas for
    potential chip antennas.
    [Chip Antenna.kicad_pcb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]
2017-06-19 Add various datasheets
    Datasheets include half-wave monopole antennas, crystals, and pin
    headers.
2017-06-19 Add modified edge-feed SMA footprint
2017-06-19 Add KiCad backup files to .gitignore
2017-06-19 Fix .gitignore
    Now includes kicad-pcb backup file
2017-06-19 Add symbol and footprint for SAMB11
    [base.kicad_pcb, base.sch]
2017-06-19 Add initial schematic for base central
    Added the crystal and antenna circuitry with a combinations of reference
    and placeholder values. SWD debugger connection is partially complete.
    [base.sch]
2017-06-19 Add complete schematic for base central
    SWD connection has been completed along with power connections.
    [base.sch]
2017-06-19 Add schematic for base transceiver
    Finished symbol and footprint for XBee PRO, and connected through
    hierarchy to central. Footprints for both crystals still need to be
    completed.
    [base-transceiver.sch, base.sch]
2017-06-19 Add initial layout for base daughterboard
    Started the initial layout of the daughterboard with the
    microcontroller. The inductors and crystals have placeholder footprints,
    while the antenna and ferrite bead are TBD. Currently using default SMD
    0402 size, but compact layout is still difficult to achieve. Crystals
    have been placed as close as possible to the oscillator pins, but ground
    return path is not optimized. Extent of components to be placed on
    daughterboard still not finalized.
    [base-transceiver.sch, base.kicad_pcb, base.sch]
2017-06-19 Cleanup crystals and 2.4GHz RF end
    UART pins dedicated for 900MHz XBee operations may need to be moved,
    keeping the 2.4GHz and 900MHz signals as far apart as possible. SMA jack
    substituted for 2.4GHz antenna for first prototype; expecting to measure
    input impedance.
    [base-transceiver.sch, base.kicad_pcb, base.sch]
2017-06-19 Add more progress to crystal and XBee routing
    Crystal has been moved to create a cleaner top layer for better signal
    pathing. Daughterboard concept starting to be realized by adding vias
    of pin header dimensions. Power routing still needs to be redone, and
    and holes for ground header pins need to be placed.
    [base-power_budget.xlsx, base-transceiver.sch, base.kicad_pcb, base.sch]
2017-06-19 Add header pins into design
    Header pins have been implemented into design, keeping in mind the
    prototyping goal of a daugther-mother board design. For first revision,
    the plan has changed to become a single board. For further revisions,
    assuming the daugtherboard portion works properly, it will be sheared
    and mounted on header pins, positioned meticulously with convenient
    vias. Power is almost completely routed. Ground vias to be completed.
    [base-transceiver.sch, base.kicad_pcb, base.sch]
2017-06-19 Cleanup base schematic and layout
    Power routes have been placed to completely cover the entire board.
    Crystal adjusted slightly to avoid the UART TX signal line. More vias
    dispersed around the board for better ground connections. Gerber files
    have been created and are ready to be tiled.
    [base-transceiver.sch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]
2017-06-19 Add multiple tilings for board run
    Finished tiling base station, audio amp, LED array, two 900MHz antennas,
    and power supply v2.
    [915 PCB Antenna 01-B.Cu.gbr, 915 PCB Antenna 01-B.Mask.gbr, 915 PCB Antenna 01-B.SilkS.gbr, 915 PCB Antenna 01-F.Cu.gbr, 915 PCB Antenna 01-F.Mask.gbr, 915 PCB Antenna 01-F.SilkS.gbr, 915 PCB Antenna 01-Margin.gbr, 915 PCB Antenna 01-drl_map.gbr]
2017-06-19 Add final tiling for second revision test board
    [button_1_00-B.Cu.gbr, button_1_00-B.SilkS.gbr, button_1_00-F.Cu.gbr, button_1_00-F.SilkS.gbr, button_1_00-Margin.gbr, button_1_00.drl]
2017-06-19 Fix missing edge cut gerber file
2017-06-19 Add new revision for patch antenna
    New revision shrinks the first revision patch antenna dimensions to
    achieve a higher resonance frequency. Feedline was moved closer to the
    center to lower the characteristic impedance. The SMA footprint was
    edited to remove error with unconnected thermal relief. Layout for the
    antenna was simplified with the footprint creator.
    [patch-B.Cu.gbr, patch-B.Mask.gbr, patch-B.SilkS.gbr, patch-Edge.Cuts.gbr, patch-F.Cu.gbr, patch-F.Mask.gbr, patch-F.SilkS.gbr, patch-Margin.gbr]
2017-06-19 Add alt version of patch antenna with balun
    Copied rev0.2 patch antenna and placed a balun in between the SMA link
    and the antenna feed. Standardize test board size between the balun and
    non-balun designs. Balun balanced feed is questionable; currently placed
    to ground. Also changed SMA connector via to have no thermal reliefs.
    [patch.kicad_pcb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]
2017-06-19 Update power budget
    [base-power_budget.xlsx]
2017-06-19 Add display footprint
    Cleaned up footprint documentation.
2017-06-19 Fix annular ring clearance
    [base-B.Cu.gbr, base-B.Mask.gbr, base-B.SilkS.gbr, base-F.Cu.gbr, base-F.Mask.gbr, base-F.SilkS.gbr, base-Margin.gbr, base.drl]
2017-06-19 Add 16x4 LCD display symbol
    Symbol and schematic started for the Crystalfontz display to be used
    for user interface. Display contrast and LCD brightness settings need
    to configured based on breadboard testing. Layout will be reworked to
    properly accompany the mass pin usage of the display.
    [base-display.sch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]
2017-06-19 Cleanup previous revision traces for new layout
    Moving forward with full base station layout. Crystals, power caps, and
    2.4GHz antenna placed. Mounting hole placements should coincide with
    display mounting holes. May want to rotate XBee placement to allow push
    buttons to be placed to the right of the display.
    [base-display.sch, base-transceiver.sch, base.kicad_pcb, base.sch]
2017-06-19 Add initial display connections
    Traces can be carefully placed underneath display footprint due to
    elevated model. Patch antenna copper voids need to be understood.
    [base.kicad_pcb, base.sch]
2017-06-19 Add new tests for patch antenna
    Two new test boards laid out to test impedance and performance due to
    the effect of larger copper void space in the presence of nearby ground
    copper, one board with a matching circuit and the other without. Traces
    no longer follow the optimal transmission line width for 50ohm
    performance due to the use of 0402 SMD technology.
    [base.kicad_pcb, base.sch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]
2017-06-19 Add gerbtool files for new patch tests
    [patch.kicad_pcb, patch_balun.kicad_pcb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]
2017-06-19 Update display and XBee position
    Display is now placed on top of uC to shrink total package dimensions
    and the XBee has been moved to accompany this change. Net vias have
    been fixed to fit Bay Area Circuits' design constraints.
    [base-display.sch, base-transceiver.sch, base.kicad_pcb, base.sch]
2017-06-19 Cleanup balun patch to match regular patch antenna
    [patch_balun-B.Cu.gbr, patch_balun-B.Mask.gbr, patch_balun-B.SilkS.gbr, patch_balun-F.Cu.gbr, patch_balun-F.Mask.gbr, patch_balun-F.SilkS.gbr, patch_balun-Margin.gbr, patch_balun.drl]
2017-06-19 Add tiling for antenna test boards
    [915 Chip Antenna-B.Cu.gbr, 915 Chip Antenna-B.Mask.gbr, 915 Chip Antenna-B.SilkS.gbr, 915 Chip Antenna-F.Cu.gbr, 915 Chip Antenna-F.Mask.gbr, 915 Chip Antenna-F.SilkS.gbr, 915 Chip Antenna-Margin.gbr, 915 Chip Antenna-NPTH-drl_map.gbr]
2017-06-19 revamped button heavily
    [button_1_00.kicad_pcb, button_1_00.sch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]
2017-06-19 rejoin the pack
    [button_1_00.kicad_pcb, button_1_00.sch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]
2017-06-19 pushing artwork for second revision button
    [CC2511_USB_Dongle_1_3.pcb, IFA_USB.dxf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]
2017-06-19 updated design, layout, and appnotes; rev3
    [button-B.Cu.gbr, button-B.Mask.gbr, button-B.SilkS.gbr, button-F.Cu.gbr, button-F.Mask.gbr, button-F.SilkS.gbr, button-Margin.gbr, button.drl]
2017-06-19 rev3 prog
    [button.kicad_pcb, button.sch]
2017-06-19 rev3 prog, almost there...
    [button.kicad_pcb]
2017-06-19 button, rev3
    [button-B.Cu.gbr, button-B.Mask.gbr, button-B.SilkS.gbr, button-F.Cu.gbr, button-F.Mask.gbr, button-F.SilkS.gbr, button-Margin.gbr, button.drl]
2017-06-19 added folder, button_elder, to button subtree
    [button-B.Cu.gbr, button-B.Mask.gbr, button-B.SilkS.gbr, button-F.Cu.gbr, button-F.Mask.gbr, button-F.SilkS.gbr, button-Margin.gbr, button.drl]
2017-06-19 Fix power and display routing with proper via size
    [base-display.sch, base.kicad_pcb, base.sch]
2017-06-19 Add USB micro B receptacle footprint
    USB B footprint generated for potential data/debugging connection.
    XBee could potentially move to bottom right corner of layout by using
    UART pins near the bottom of the uC (12-20) and moving the display pins
    to the top (36-42). Speaker can be placed directly to the above (to the
    right in layout) the display.
    [base.kicad_pcb, base.sch]
2017-06-19 Update display and XBee position once more
    GPIO pins were rearranged to achieve a tighter fit on the available
    components. Patch antenna is now replaced with SMA connector for first
    prototype. Buttons will be simulated with a pin header short. Audio
    speaker is planned to go below the display, perhpas on the side of the
    housing.
    [base-transceiver.sch, base.kicad_pcb, base.sch]
2017-06-19 Add power traces throughout board
    Power is almost fully distributed to the entire board. All signal traces
    have been connected. Copper pours still need to removed from the
    RF region. The ferrite bead should also be moved.
    [base-display.sch, base-transceiver.sch, base.kicad_pcb, base.sch]
2017-06-19 Cleanup unconnnected nets and RF region
    All remaining power traces have been connected, and copper voids have
    been added around the SMA.
    [base.kicad_pcb]
2017-06-19 Add ground stitch vias and silk identifiers
    Base station layout is finished, and artwork has been generated.
    [base-display.sch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]
2017-06-19 Add tiling for uC test boards
    [button_1_00.kicad_pcb, button_1_00.sch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]
2017-06-19 Fix BAC DFM flagged errors
    Slight change to copper clearance and specific via pads.
    [base-B.Cu.gbr, base-B.Mask.gbr, base-B.SilkS.gbr, base-F.Cu.gbr, base-F.Mask.gbr, base-F.SilkS.gbr, base-Margin.gbr, base.drl]
2017-06-19 Add power supply to tile
    [PowerSupplyV2-B.Cu.gbr, PowerSupplyV2-B.Mask.gbr, PowerSupplyV2-B.SilkS.gbr, PowerSupplyV2-F.Cu.gbr, PowerSupplyV2-F.Mask.gbr, PowerSupplyV2-F.SilkS.gbr, PowerSupplyV2-Margin.gbr, PowerSupplyV2.drl]
2017-06-19 Merge base board with power traces
    Cleanup power elements and removed some vias to comply with drill hole
    board density.
    [base-B.Cu.gbr, base-B.Mask.gbr, base-B.SilkS.gbr, base-F.Cu.gbr, base-F.Mask.gbr, base-F.SilkS.gbr, base-Margin.gbr, base.drl]
2017-06-19 Cleanup archive and pdfs
    [base-display.sch]
2017-06-19 Update pad sizes on pin headers and XBee
    [base-display.sch, base.sch]
2017-06-19 Update display, XBee, and USB trace widths
    Experimenting with new design constraints of 0.75mil clearance and
    0.8mil signal trace widths.
    [base.kicad_pcb]
2017-06-19 Add patch antennas with transmission line matching
    [patch-B.Cu.gbr, patch-B.Mask.gbr, patch-B.SilkS.gbr, patch-F.Cu.gbr, patch-F.Mask.gbr, patch-F.SilkS.gbr, patch-Margin.gbr, patch.drl]
2017-06-19 Tile new antenna revisions
    [915 Chip Antenna-B.Cu.gbr, 915 Chip Antenna-F.Cu.gbr, 915 Chip Antenna-F.Mask.gbr, 915 Chip Antenna-F.SilkS.gbr, 915 Chip Antenna-Margin.gbr, 915 Chip Antenna-NPTH-drl_map.gbr, 915 Chip Antenna-NPTH.drl, 915 Chip Antenna-drl_map.gbr]
2017-06-19 Revamp base station layout
    26MHz crystal moved to the top layer after reducing pad size. Slight
    spacing with SMD components to avoid difficulties with hand soldering.
    Component sections moved around for a more compact final layout. Antenna
    section still needs to changed depending on transmission line matching
    circuit. Traces to be finished.
    [base-display.sch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]
2017-06-19 Update base component placement and routing
    New base station revision updated for a more complete prototype. Buttons
    placed into layout, and SWD debugger pin header fixed.
    [base.kicad_pcb, base.sch]
2017-06-19 Add stitch vias and fix silkscreen identifiers
    [base-B.Cu.gbr, base-B.Mask.gbr, base-B.SilkS.gbr, base-F.Cu.gbr, base-F.Mask.gbr, base-F.SilkS.gbr, base-Margin.gbr, base.drl]
2017-06-19 Add vertical SMA, matching stub, and dimensions
    [base-B.Cu.gbr, base-B.Mask.gbr, base-B.SilkS.gbr, base-F.Cu.gbr, base-F.Mask.gbr, base-F.SilkS.gbr, base-Margin.gbr, base.drl]
2017-06-19 Tile uC and antenna boards
    [915 Chip Antenna-B.Cu.gbr, 915 Chip Antenna-B.Mask.gbr, 915 Chip Antenna-B.SilkS.gbr, 915 Chip Antenna-F.Cu.gbr, 915 Chip Antenna-F.Mask.gbr, 915 Chip Antenna-F.SilkS.gbr, 915 Chip Antenna-Margin.gbr, 915 Chip Antenna.drl]
2017-06-19 Add initial base BOM
    [base-bom.xlsx]
2017-06-19 Add updated base BOM
    Now includes most RF components and SMDs.
    [base-bom.xlsx]
2017-06-19 Fix footprints for connectors and crystal
    Unnecessary SMDs in the matching circuit and 0 ohm link removed from the
    schematic. Certain resistor and capacitor values updated to new offical
    BOM components.
    [base-bom.xlsx, base.kicad_pcb, base.sch]
2017-06-19 Move several components and traces around
    All components except SWD have been connected. May want to route SWD and
    button signals on opposite sides.
    [base-bom.xlsx, base.kicad_pcb, base.sch]
2017-06-19 Finish new base station and tile boards
    [915 Chip Antenna-B.Cu.gbr, 915 Chip Antenna-B.Mask.gbr, 915 Chip Antenna-B.SilkS.gbr, 915 Chip Antenna-F.Cu.gbr, 915 Chip Antenna-F.Mask.gbr, 915 Chip Antenna-F.SilkS.gbr, 915 Chip Antenna-Margin.gbr, 915 Chip Antenna.drl]
2017-06-19 Add new dimensions for base station
    [base-bom.xlsx, base.kicad_pcb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]
2017-06-19 Fix base station dimensions and cleanup datasheets
    [base-bom.xlsx]
2017-06-19 Update all signal traces to new widths
2017-06-22 Revert base layout to r1.0 with new footprints
    Base designs of r1.0 and r1.1 merged. r1.1 of the base station did not
    work, while r1.0 is the last known working version. Footprints from r1.0
    kept. Problem with r1.1 suspected to be due to wake-up timing on VDDIO
    and CHIP_EN pins.
    [base-B.Cu.gbr, base-B.Mask.gbr, base-B.SilkS.gbr, base-F.Cu.gbr, base-F.Mask.gbr, base-F.SilkS.gbr, base-Margin.gbr, base.drl]
